mattibmt98/Sata-Multiplier-power-supply/kicad/bom.csv

Reference | Value | Footprint | MPN | DigiKey | DNP
C11,C13,C23,C33,C43,C53 | 1uF | Capacitor_SMD:C_0603_1608Metric | CL10A105KB8NNNC | 1276-1860-1-ND
C12,C22,C32,C42,C52 | 220uF/25V | Capacitor_THT:CP_Radial_D8.0mm_P3.50mm | UVZ1E221MPD | 493-1302-ND
C14,C34,C54 | 10uF/50V | Capacitor_SMD:C_1206_3216Metric | CL31A106KBHNNNE | 1276-2876-1-ND | DNP
C15,C16,C35,C36,C55,C56 | 100nF | Capacitor_SMD:C_0603_1608Metric | CL10B104KB8NNNC | 1276-1000-1-ND | DNP
C17,C18,C37,C38,C57,C58 | 22uF/25V | Capacitor_SMD:C_1206_3216Metric | CL31A226KAHNNNE | 1276-3047-1-ND | DNP
C21 | 2.2uF | Capacitor_SMD:C_0603_1608Metric | CL10A225KO8NNNC | 1276-1040-1-ND
C24,C44,C83,C93 | 10uF/50V | Capacitor_SMD:C_1206_3216Metric | CL31A106KBHNNNE | 1276-2876-1-ND
C25,C26,C45,C46 | 100nF | Capacitor_SMD:C_0603_1608Metric | CL10B104KB8NNNC | 1276-1000-1-ND
C27,C28,C47,C48 | 22uF/25V | Capacitor_SMD:C_1206_3216Metric | CL31A226KAHNNNE | 1276-3047-1-ND
C31 | 4.7uF | Capacitor_SMD:C_0603_1608Metric | CL10A475KO8NNNC | 1276-1784-1-ND
C41 | 10uF | Capacitor_SMD:C_1206_3216Metric | CL31A106KBHNNNE | 1276-2876-1-ND
C51 | 22uF | Capacitor_SMD:C_1206_3216Metric | CL31A226KAHNNNE | 1276-3047-1-ND
C81,C91 | 1000uF/25V | Capacitor_THT:CP_Radial_D10.0mm_P5.00mm | UVR1E102MPD | 493-1065-ND
D11,D21,D31,D41,D51 | 8.2V | Diode_SMD:D_SOD-123 | MMSZ5237B-7-F | MMSZ5237B-FDICT-ND
D12,D22,D32,D42,D52,D81,D91 | GRN | LED_SMD:LED_0603_1608Metric
F1-F5 | 2.6A/5.2A | Fuse:Fuse_1812_4532Metric | 1812L260/16MR | F10827CT-ND
F8,F9 | 8A fast-blow | Fuse:Fuseholder_Clip-5x20mm_Bel_FC-203-22_Lateral_P17.80x5.00mm_D1.17mm_Horizontal | FC-203-22 | 507-1703-ND
J1-J5 | 12V/GND/GND/5V | Connector_PinHeader_2.54mm:PinHeader_1x04_P2.54mm_Vertical | PRPC004SAAN-RC | S1011EC-04-ND
J8,J9 | 12V DC 5-8A | Connector_BarrelJack:BarrelJack_CUI_PJ-063AH_Horizontal | PJ-063AH | CP-063AH-ND
L1,L3,L5 | 4.7uH/4.5A | Inductor_SMD:L_Bourns_SRN6045TA | SRN6045TA-4R7M | SRN6045TA-4R7MTR-ND | DNP
L2,L4 | 4.7uH/4.5A | Inductor_SMD:L_Bourns_SRN6045TA | SRN6045TA-4R7M | SRN6045TA-4R7MTR-ND
Q1-Q5 | AO3401A | Package_TO_SOT_SMD:SOT-23 | AO3401A | 785-1001-1-ND
Q8,Q9 | AOD4185 | Package_TO_SOT_SMD:TO-252-3_TabPin2 | AOD4185 | 785-1222-2-ND
R11,R21,R31,R41,R51 | 220k | Resistor_SMD:R_0603_1608Metric | RC0603FR-07220KL | 311-220KHRCT-ND
R12,R32,R52 | 56k | Resistor_SMD:R_0603_1608Metric | RC0603FR-0756KL | 311-56KHRCT-ND | DNP
R13,R33,R53 | 10k | Resistor_SMD:R_0603_1608Metric | RC0603FR-0710KL | 311-10.0KHRCT-ND | DNP
R14,R34,R54 | 100k | Resistor_SMD:R_0603_1608Metric | RC0603FR-07100KL | 311-100KHRCT-ND | DNP
R15,R25,R35,R45,R55 | 1.5k | Resistor_SMD:R_0603_1608Metric
R22,R42 | 56k | Resistor_SMD:R_0603_1608Metric | RC0603FR-0756KL | 311-56KHRCT-ND
R23,R43 | 10k | Resistor_SMD:R_0603_1608Metric | RC0603FR-0710KL | 311-10.0KHRCT-ND
R24,R44 | 100k | Resistor_SMD:R_0603_1608Metric | RC0603FR-07100KL | 311-100KHRCT-ND
R61,R62,R64 | 0R | Resistor_SMD:R_1206_3216Metric
R63 | 0R | Resistor_SMD:R_1206_3216Metric |  |  | DNP
R81,R91 | 4.7k | Resistor_SMD:R_0603_1608Metric
U1,U3,U5 | TPS563200 | Package_TO_SOT_SMD:SOT-23-6 | TPS563200DDCR | 296-43663-1-ND | DNP
U2,U4 | TPS563200 | Package_TO_SOT_SMD:SOT-23-6 | TPS563200DDCR | 296-43663-1-ND
