mattibmt98/Sata-Multiplier-power-supply/kicad/digikey_bom.csv

Order Qty | DigiKey PN | MPN | Manufacturer | Description | References | Board Qty | Fitted in default build | Note
10 | 445-7468-1-ND | C1608X5R1H105K080AB | TDK | 1uF 50V X5R 0603 | C11,C13,C23,C33,C43,C53 | 6 | 6 | SUBSTITUTE for Samsung CL10A105KB8NNNC (out of stock)
10 | 445-7478-1-ND | C1608X5R1C475K080AC | TDK | 4.7uF 16V X5R 0603 | C31 | 1 | 1 | SUBSTITUTE for Samsung CL10A475KO8NNNC (out of stock)
10 | 1276-1040-1-ND | CL10A225KO8NNNC | Samsung | 2.2uF 16V X5R 0603 | C21 | 1 | 1 | as designed
12 | 311-1344-1-ND | CC0603KRX7R9BB104 | YAGEO | 100nF 50V X7R 0603 | C15,C16,C25,C26,C35,C36,C45,C46,C55,C56 | 10 | 4 | SUBSTITUTE for Samsung CL10B104KB8NNNC (out of stock)
10 | 13-CC1206KKX5R9BB106CT-ND | CC1206KKX5R9BB106 | YAGEO | 10uF 50V X5R 1206 | C14,C24,C34,C44,C54,C83,C93,C41 | 8 | 5 | SUBSTITUTE for Samsung CL31A106KBHNNNE (out of stock until Jul 2027)
13 | 445-6000-1-ND | C3216X5R1E226M160AB | TDK | 22uF 25V X5R 1206 | C17,C18,C27,C28,C37,C38,C47,C48,C57,C58,C51 | 11 | 5 | SUBSTITUTE for Samsung CL31A226KAHNNNE (out of stock until Jul 2027)
5 | 493-1302-ND | UVZ1E221MPD | Nichicon | 220uF 25V radial 8x11.5 P3.5 | C12,C22,C32,C42,C52 | 5 | 5 | as designed
2 | P14424-ND | EEU-FR1E102 | Panasonic | 1000uF 25V radial 10mm P5.0 (22mm tall) | C81,C91 | 2 | 2 | SUBSTITUTE for Nichicon UVR1E102MPD (out of stock until Jan 2027); 2mm taller
7 | MMSZ5237B-FDICT-ND | MMSZ5237B-7-F | Diodes Inc | 8.2V 500mW zener SOD-123 | D11,D21,D31,D41,D51 | 5 | 5 | as designed
10 | 160-1446-1-ND | LTST-C191KGKT | Lite-On | Green LED 0603 | D12,D22,D32,D42,D52,D81,D91 | 7 | 7 | NEW - schematic had no part number
5 | MINISMDC260F/16-2CT-ND | MINISMDC260F/16-2 | Littelfuse | PTC 2.6A hold 5A trip 16V 1812 | F1,F2,F3,F4,F5 | 5 | 5 | SUBSTITUTE for Littelfuse 1812L260/16MR (out of stock until Dec 2026); same ratings
4 | 5923-FC-203BRIGHTTIN-ND | FC-203 BRIGHT TIN | Bel Fuse | 5x20mm fuse clip (one clip) | F8,F9 | 4 | 4 | PN 507-1703-ND was renumbered; each footprint holds 2 clips, two inputs = 4
3 | F2396-ND | 0217008.HXP | Littelfuse | Fuse 8A fast 250V 5x20mm glass | F8,F9 (cartridge) | 2 | 2 | was 10A 0217010.HXP (F2398-ND): each input now carries <=4.4A and the jack contact is 8A, so 8A; one per input + 1 spare. DigiKey PN taken from a web search of the listing - confirm on the cart
5 | 35-PRPC004SAAN-RC-ND | PRPC004SAAN-RC | Sullins | Header 1x04 2.54mm | J1,J2,J3,J4,J5 | 5 | 5 | PN S1011EC-04-ND was renumbered
2 | CP-063AH-ND | PJ-063AH | Same Sky (CUI) | DC barrel jack 2.0mm 8A | J8,J9 | 2 | 2 | as designed; second jack feeds bays 4-5
5 | 283-SDCHA1V6045-4R7-RCT-ND | SDCHA1V6045-4R7-R | Eaton | 4.7uH 4.5A Isat 6.8A 26mOhm 6x6mm | L1,L2,L3,L4,L5 | 5 | 2 | SUBSTITUTE for Bourns SRN6045TA-4R7M (out of stock until Jan 2027) - LAND PATTERN NOT VERIFIED
5 | 785-1001-1-ND | AO3401A | Alpha & Omega | P-MOSFET 30V 4A SOT-23 | Q1,Q2,Q3,Q4,Q5 | 5 | 5 | as designed
2 | 785-1222-1-ND | AOD4185 | Alpha & Omega | P-MOSFET 40V 40A TO-252 | Q8,Q9 | 2 | 2 | schematic had 785-1222-2-ND (reel of 2500); cut tape instead
10 | 311-220KHRCT-ND | RC0603FR-07220KL | YAGEO | 220k 1% 0603 | R11,R21,R31,R41,R51 | 5 | 5 | as designed
10 | 311-56KHRCT-ND | RC0603FR-0756KL | YAGEO | 56k 1% 0603 | R12,R22,R32,R42,R52 | 5 | 2 | as designed
10 | RMCF0603FT10K0CT-ND | RMCF0603FT10K0 | Stackpole | 10k 1% 0603 | R13,R23,R33,R43,R53 | 5 | 2 | SUBSTITUTE for YAGEO RC0603FR-0710KL (out of stock)
10 | RMCF0603FT100KCT-ND | RMCF0603FT100K | Stackpole | 100k 1% 0603 | R14,R24,R34,R44,R54 | 5 | 2 | SUBSTITUTE for YAGEO RC0603FR-07100KL (out of stock)
10 | 311-1.50KHRCT-ND | RC0603FR-071K5L | YAGEO | 1.5k 1% 0603 | R15,R25,R35,R45,R55 | 5 | 5 | NEW - schematic had no part number
10 | 311-4.70KHRCT-ND | RC0603FR-074K7L | YAGEO | 4.7k 1% 0603 | R81,R91 | 2 | 2 | NEW - schematic had no part number
10 | 311-0.0ERCT-ND | RC1206JR-070RL | YAGEO | 0R jumper 1206 | R61,R62,R63,R64 | 4 | 3 | NEW - schematic had no part number
5 | 296-43663-1-ND | TPS563200DDCR | Texas Instruments | Buck 4.5-17V 3A SOT-23-6 | U1,U2,U3,U4,U5 | 5 | 2 | as designed
