mattibmt98/Sata-Multiplier-power-supply/kicad/sata_psu.pdf

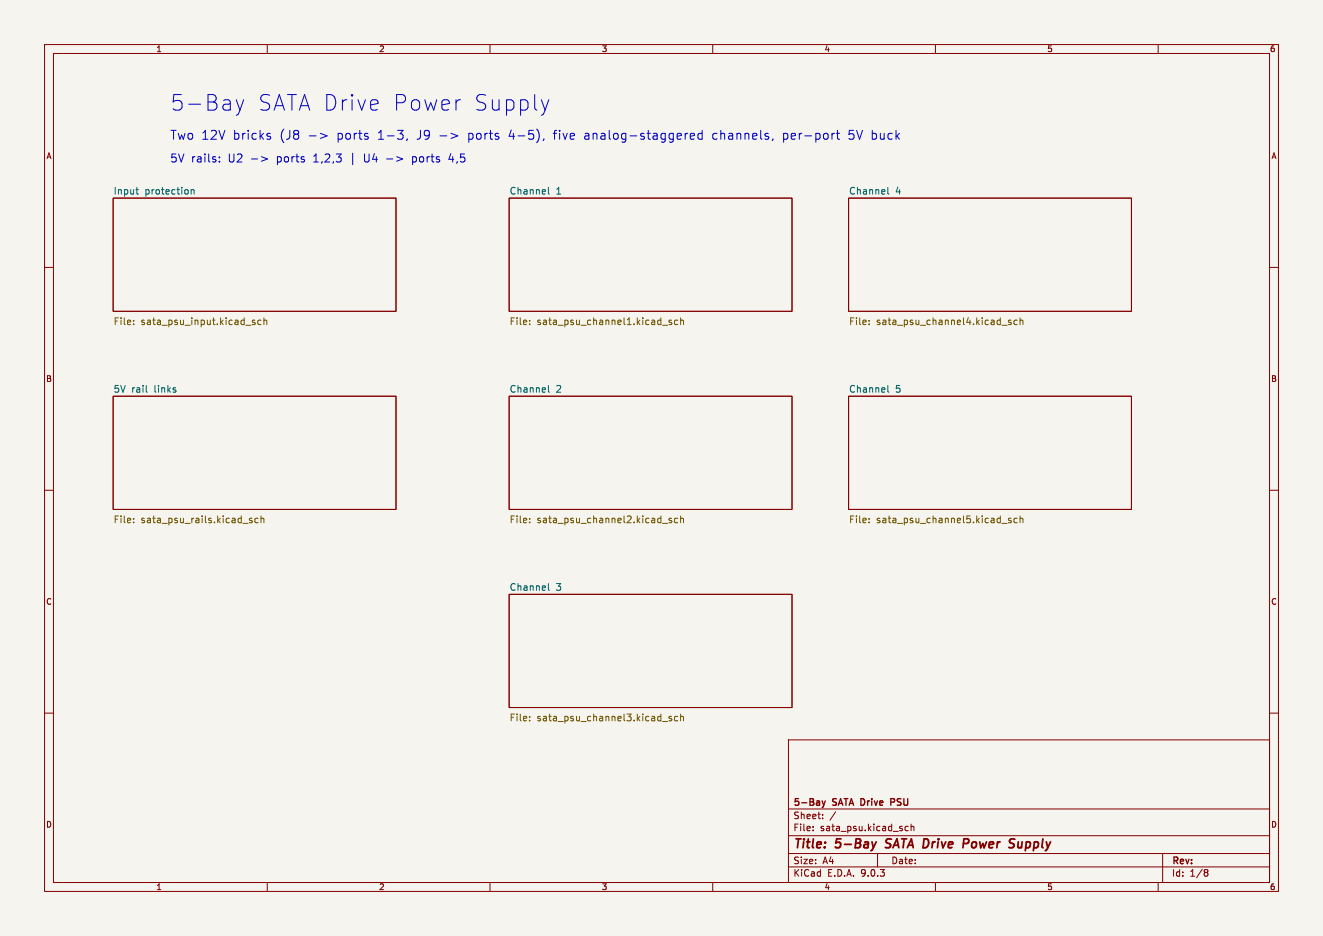
[picture p1: page 1]

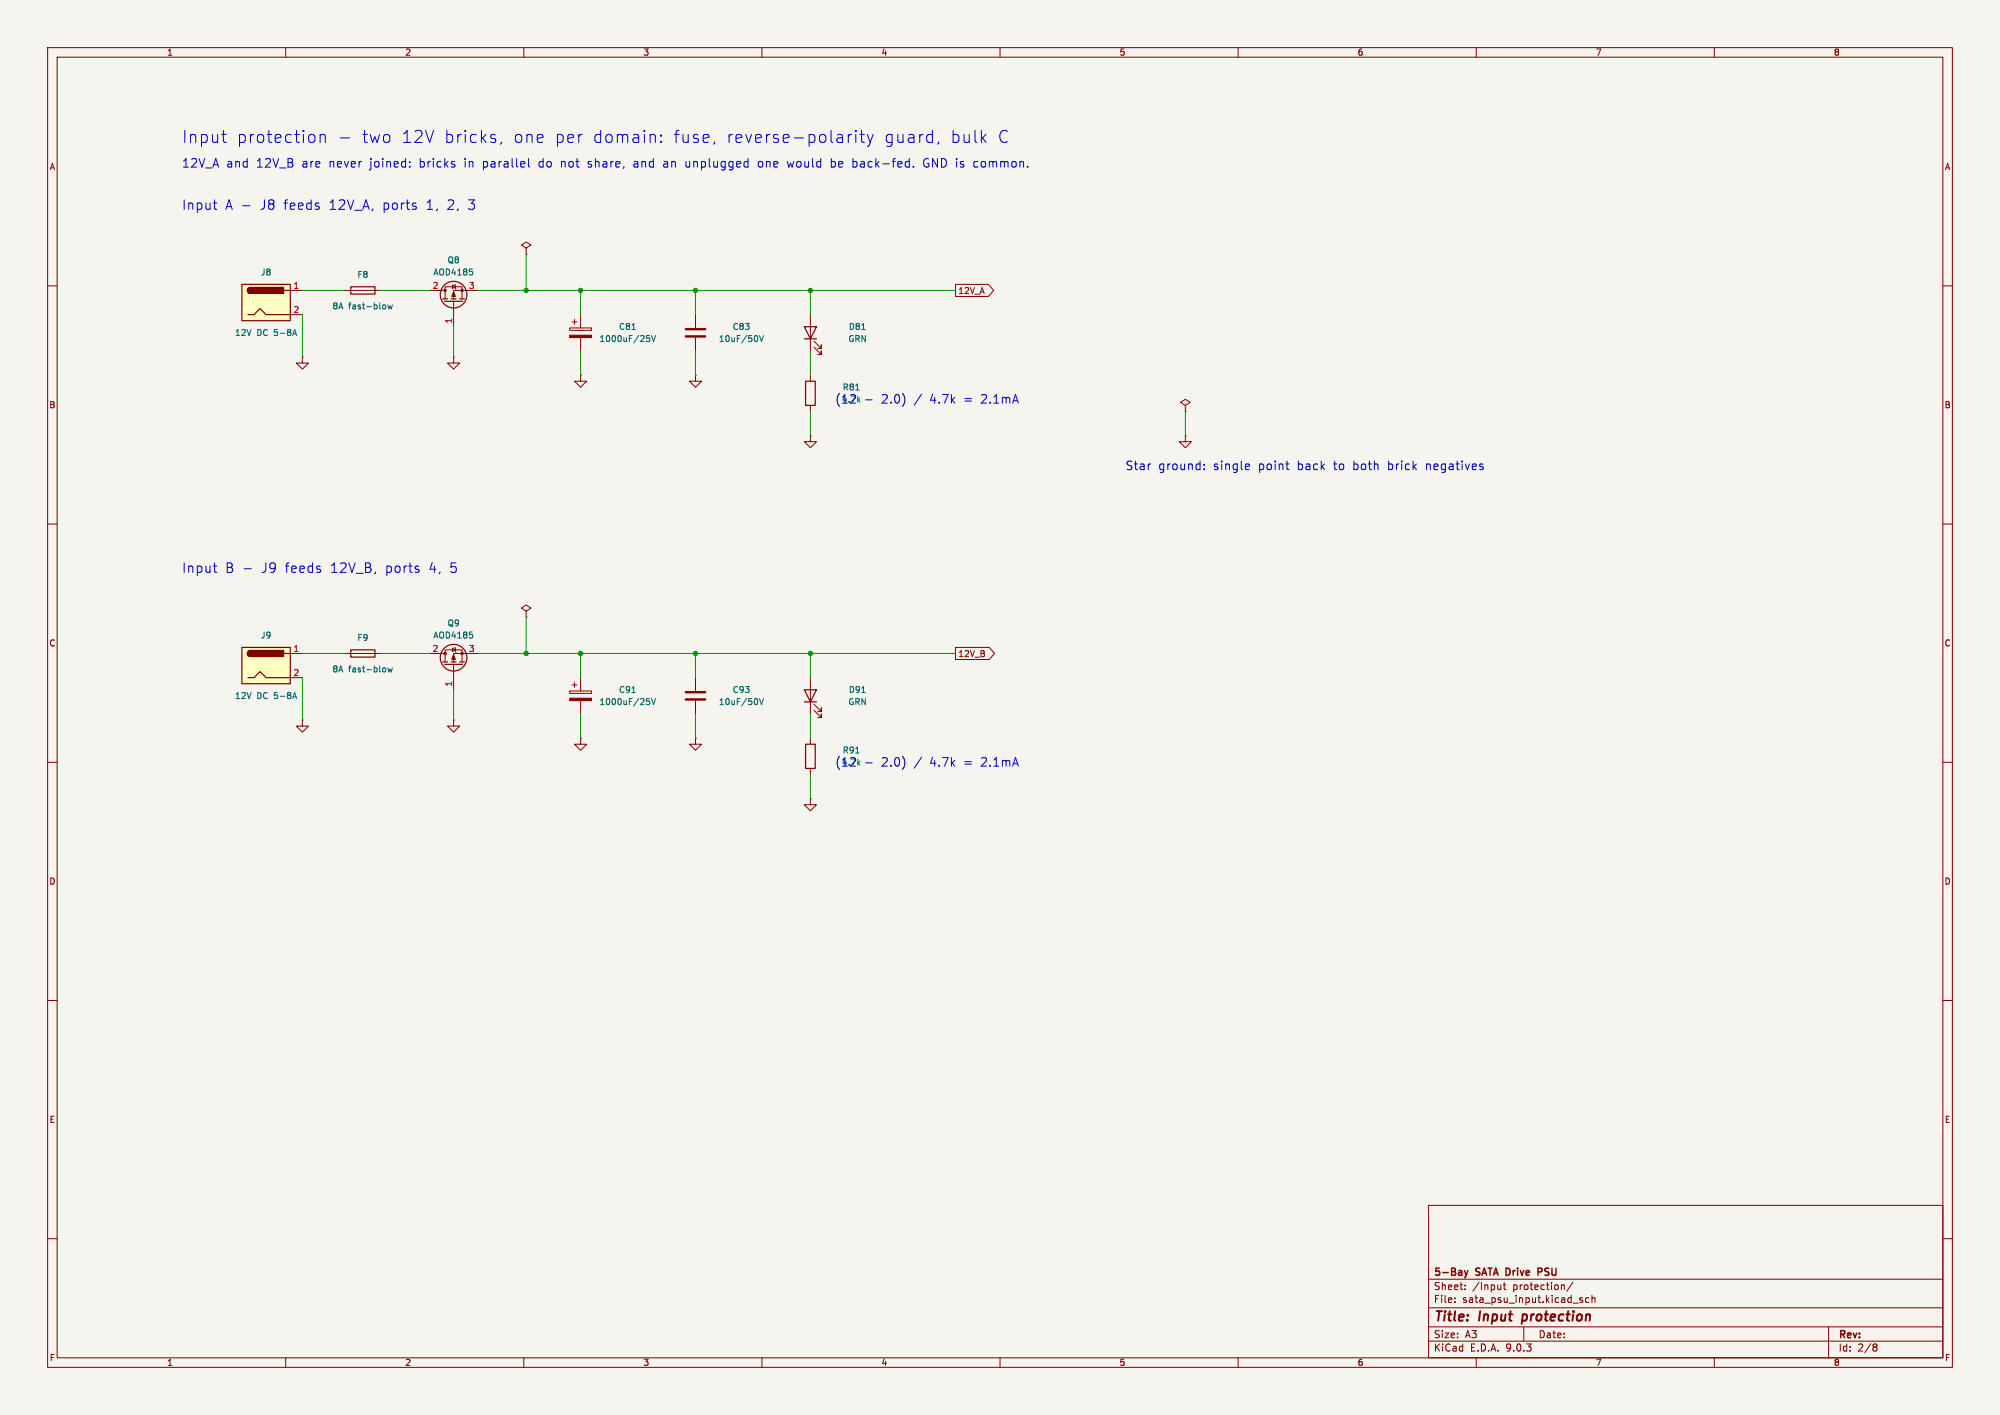
[picture p2: page 2]

Id: 2/8 Title: Input protection

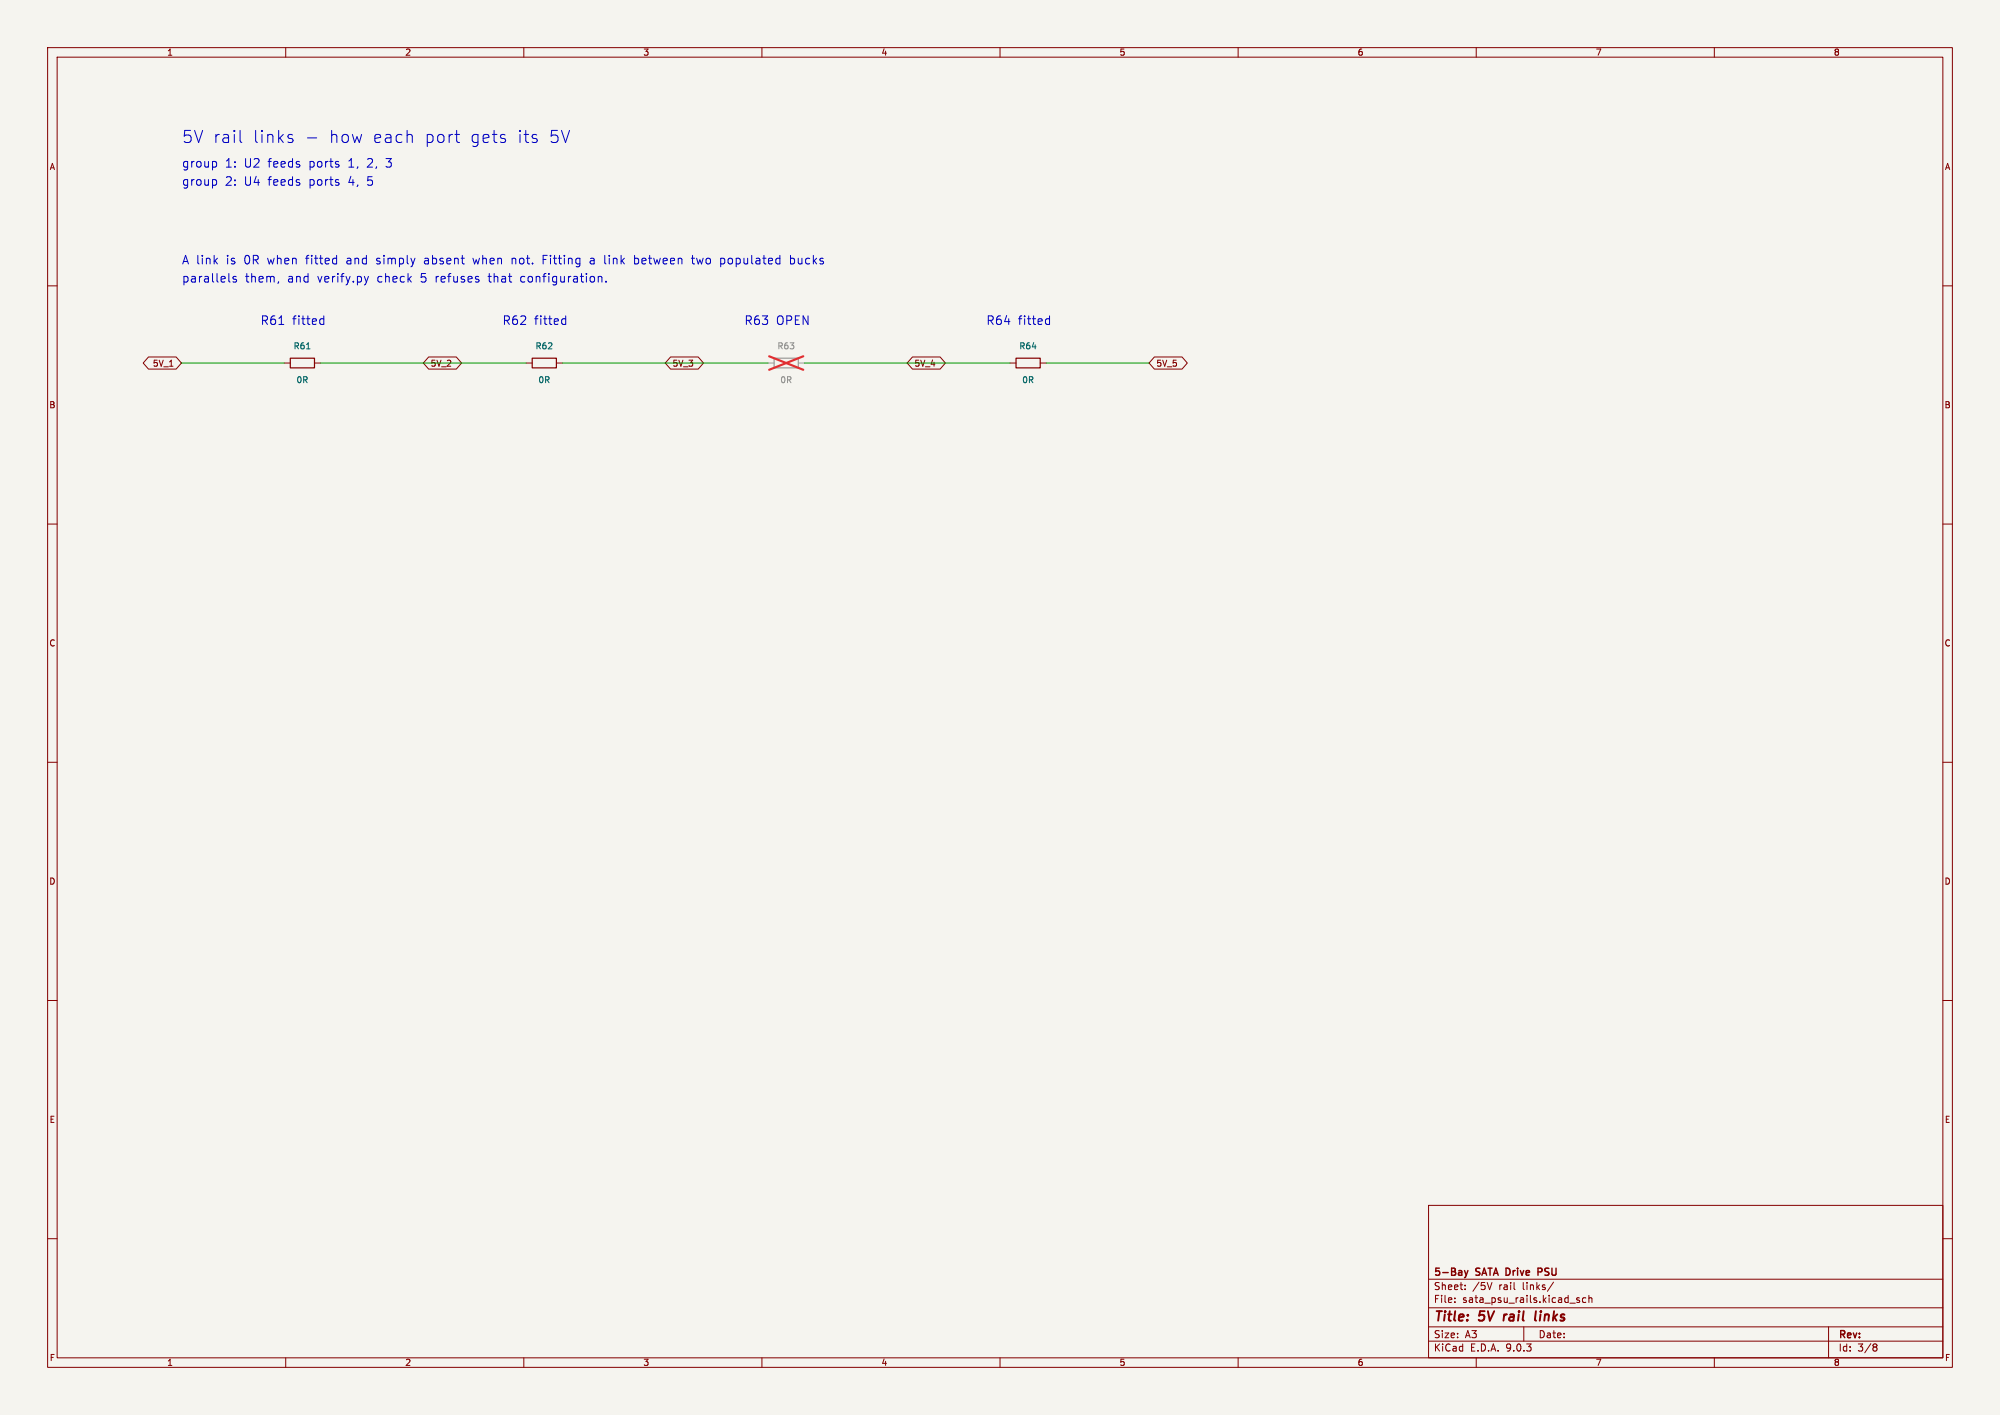
[picture p3: page 3]

Id: 3/8 Title: 5V rail links

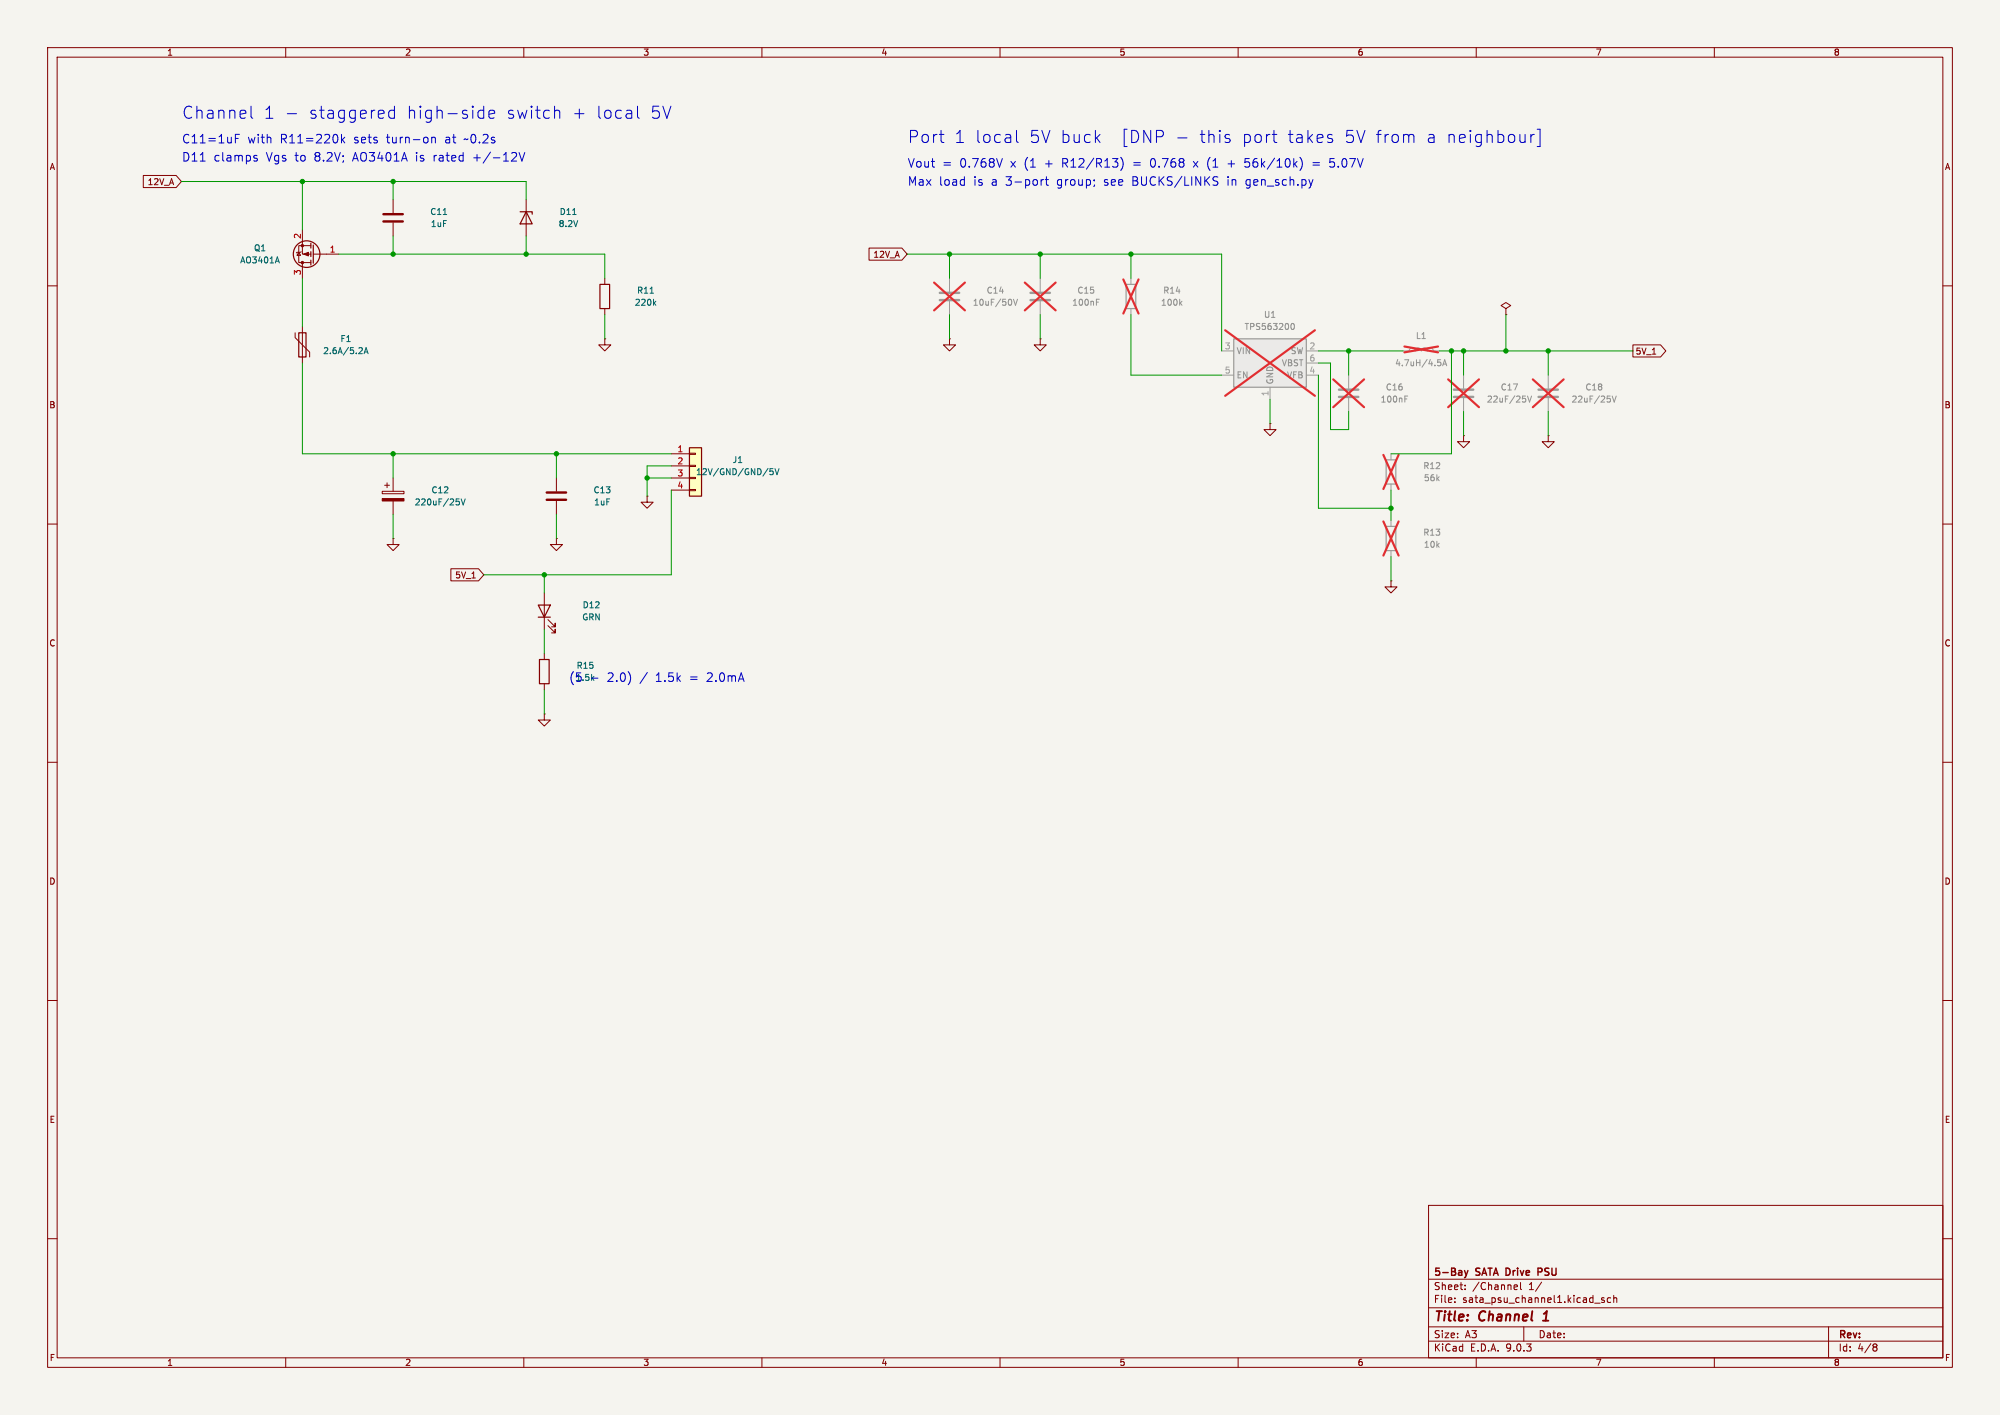
[picture p4: page 4]

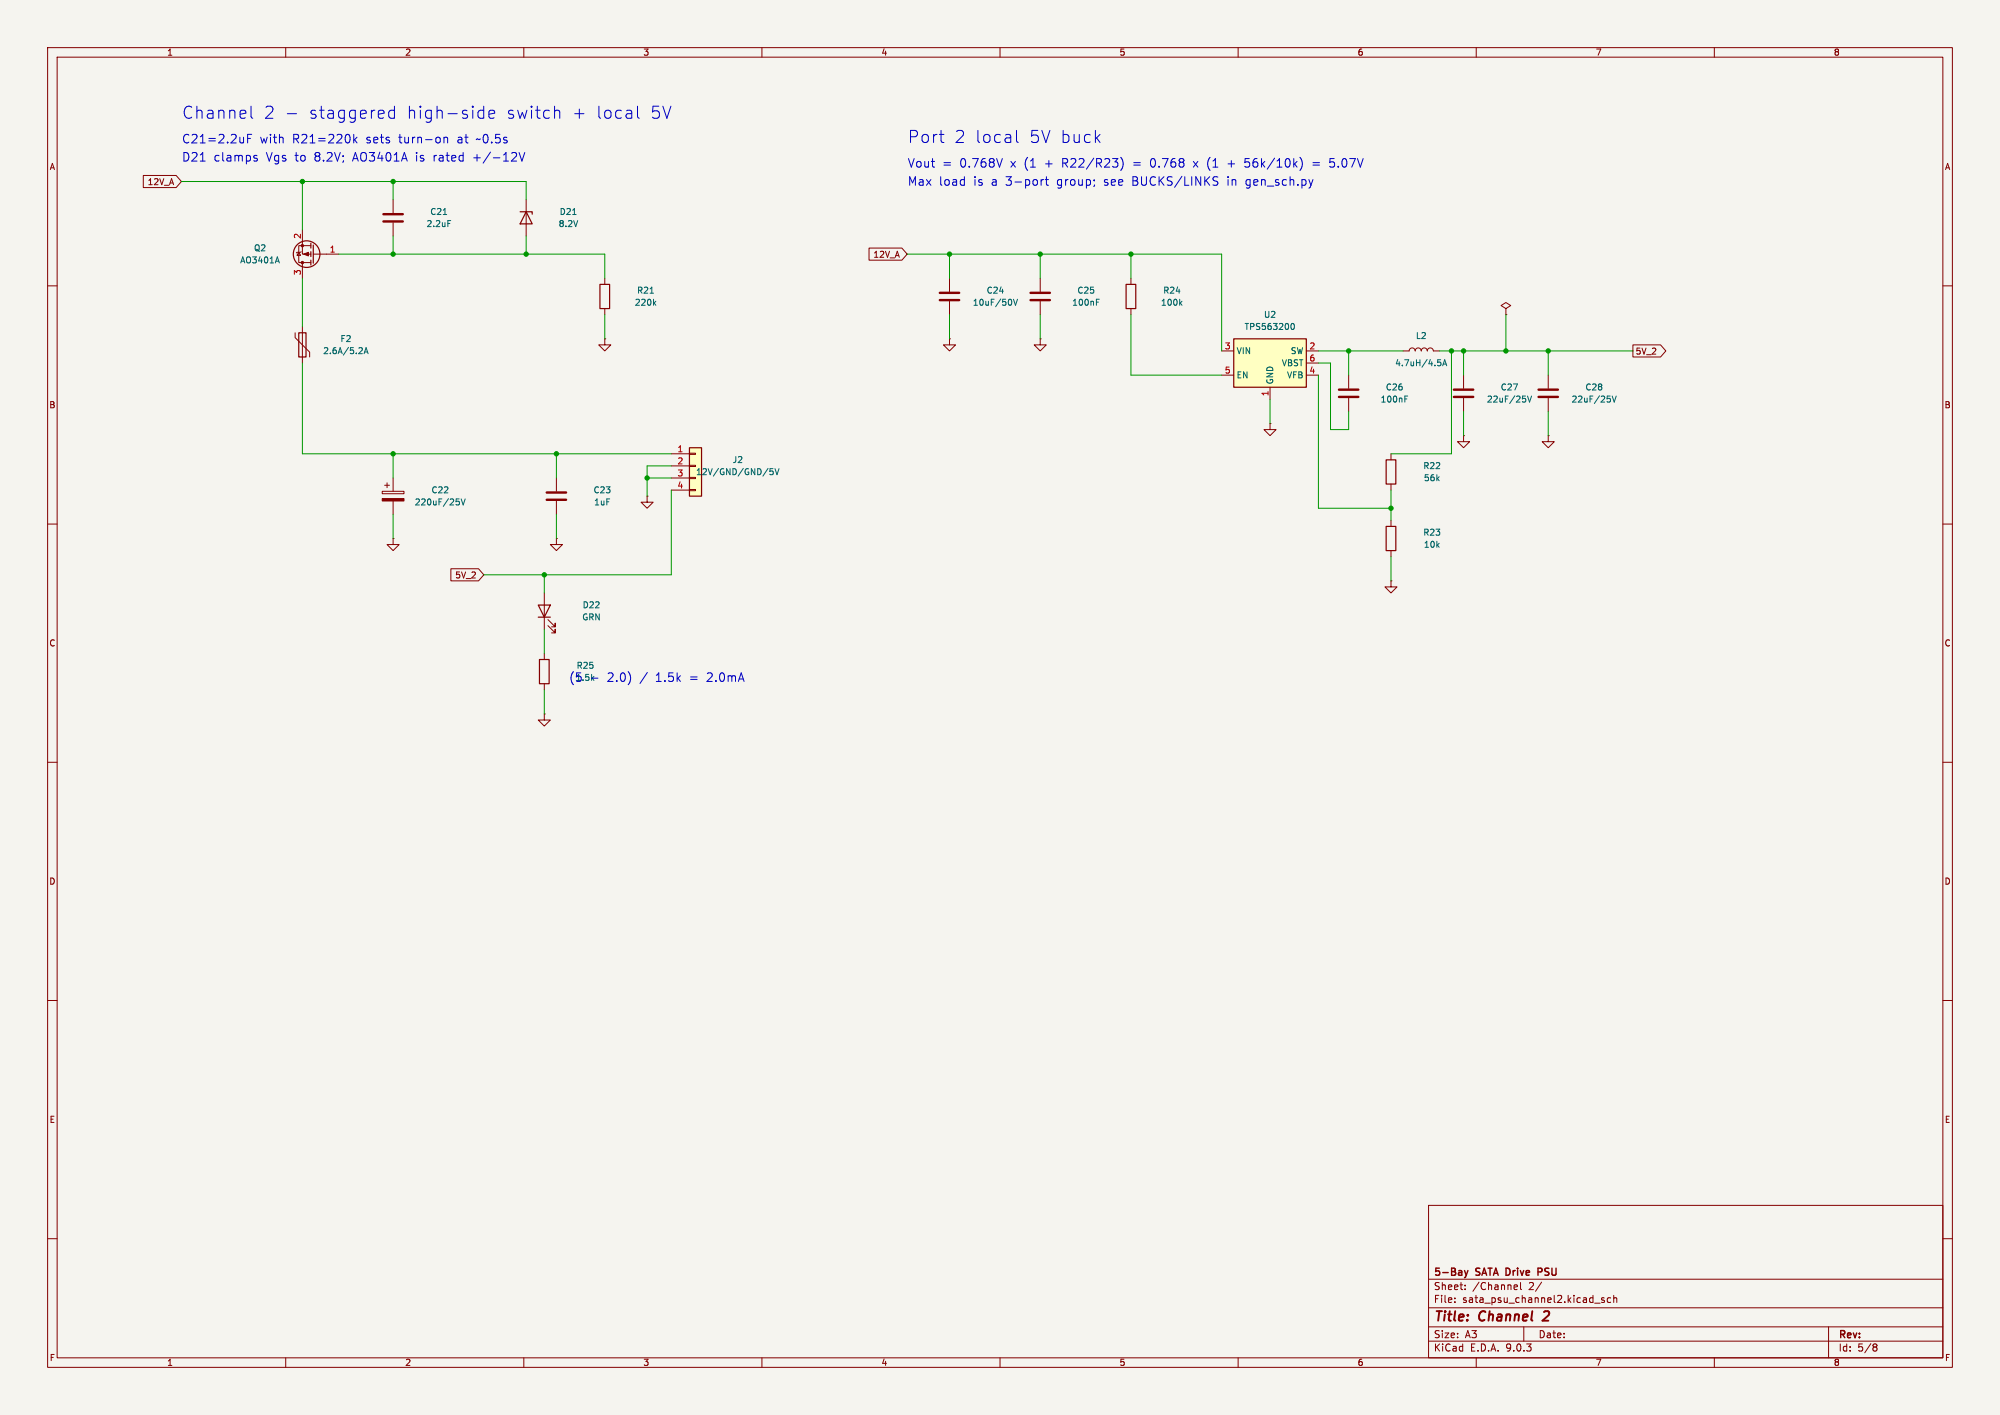
[picture p5: page 5]

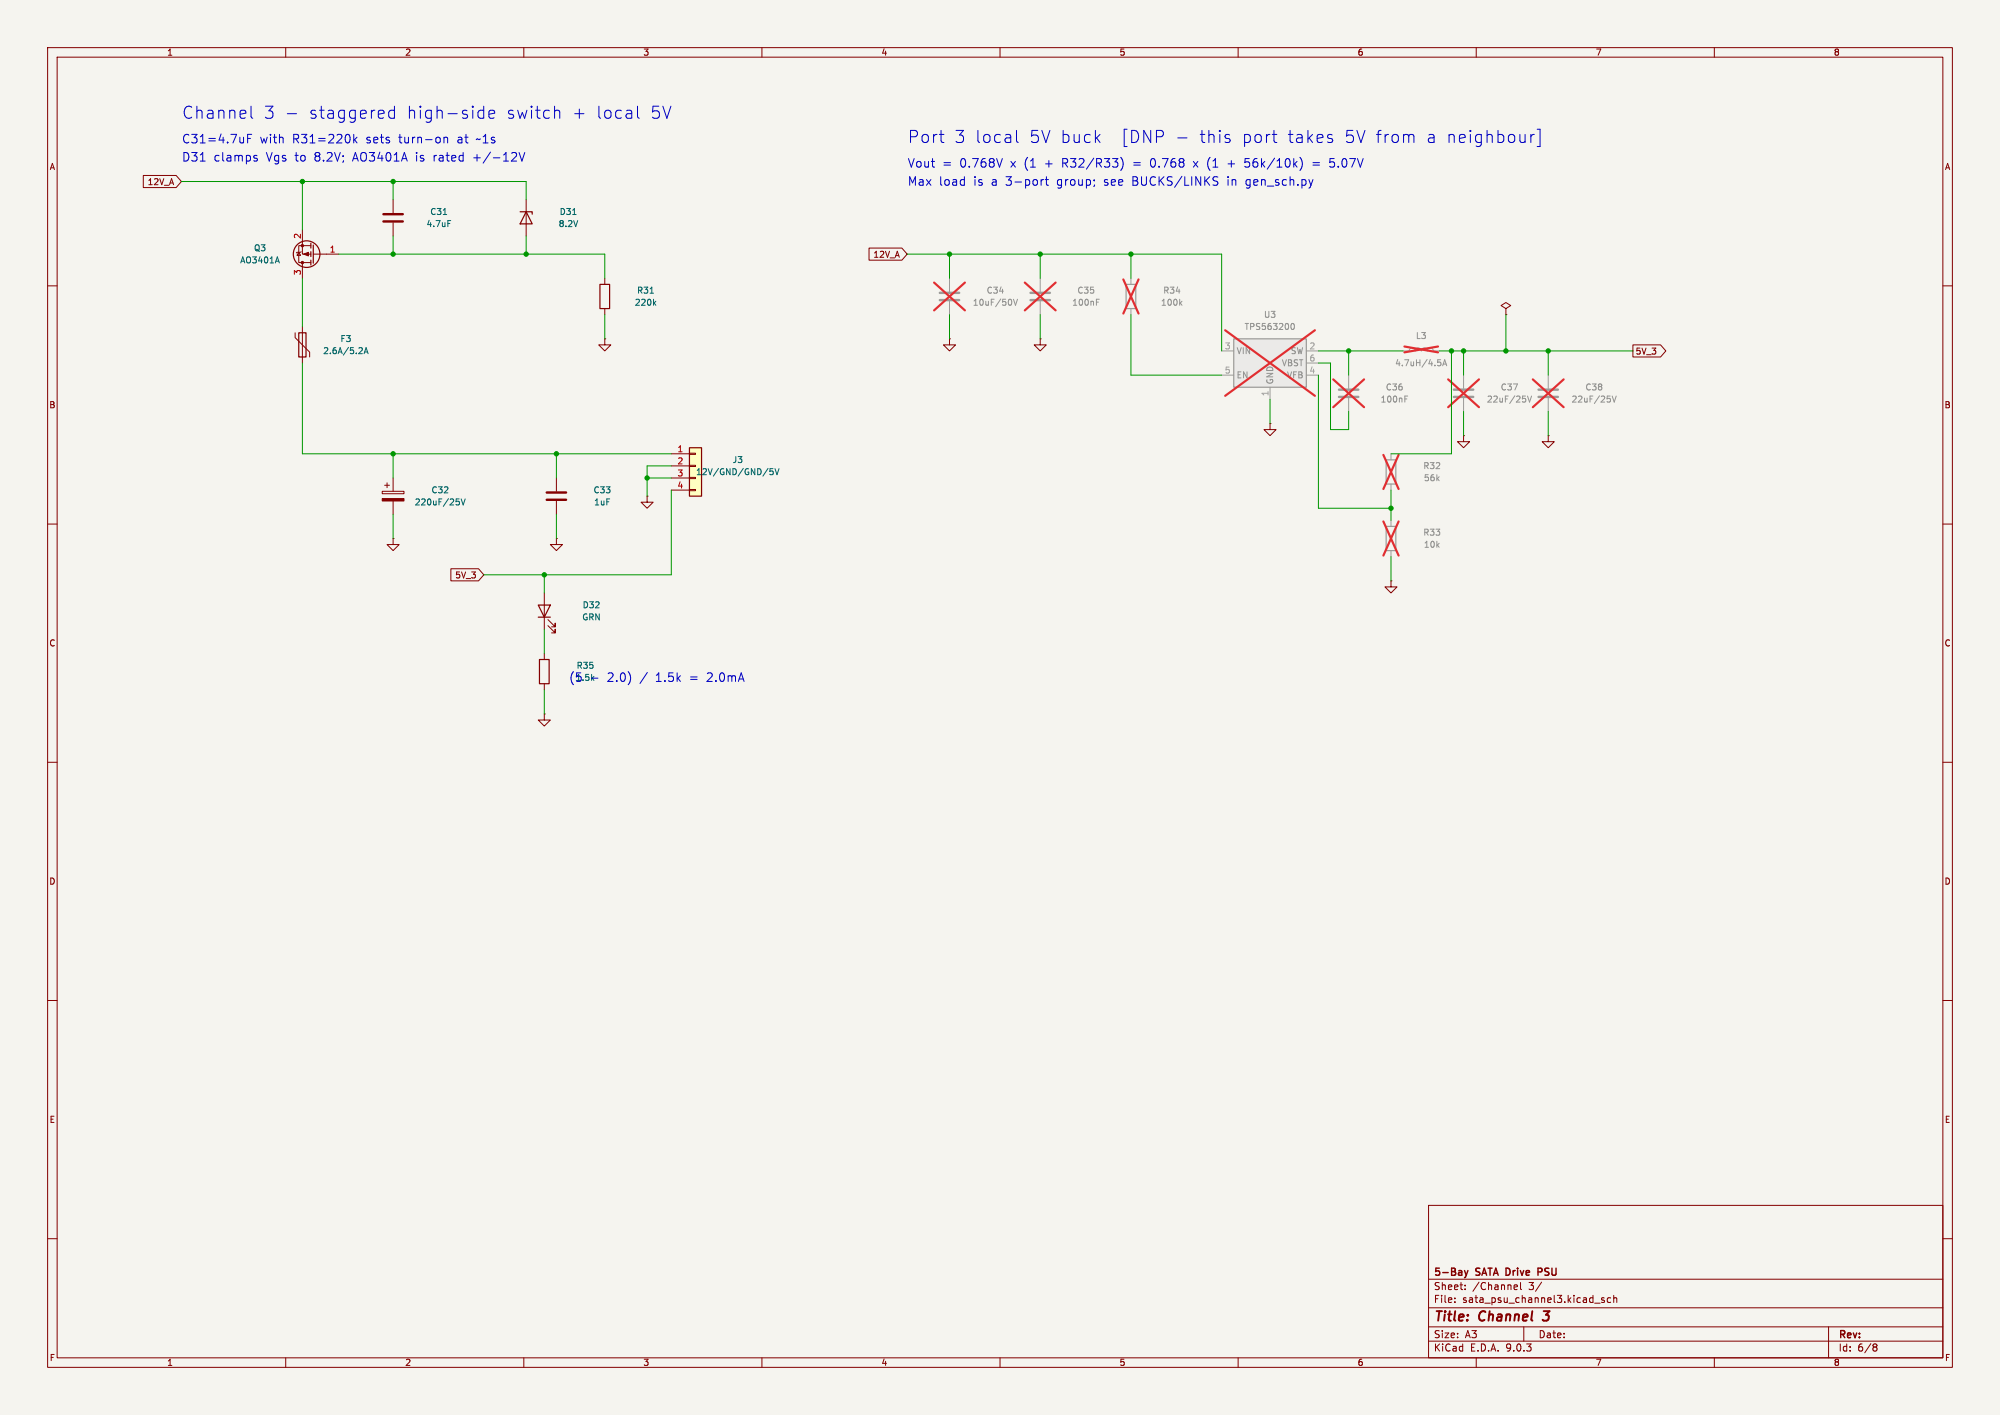
[picture p6: page 6]

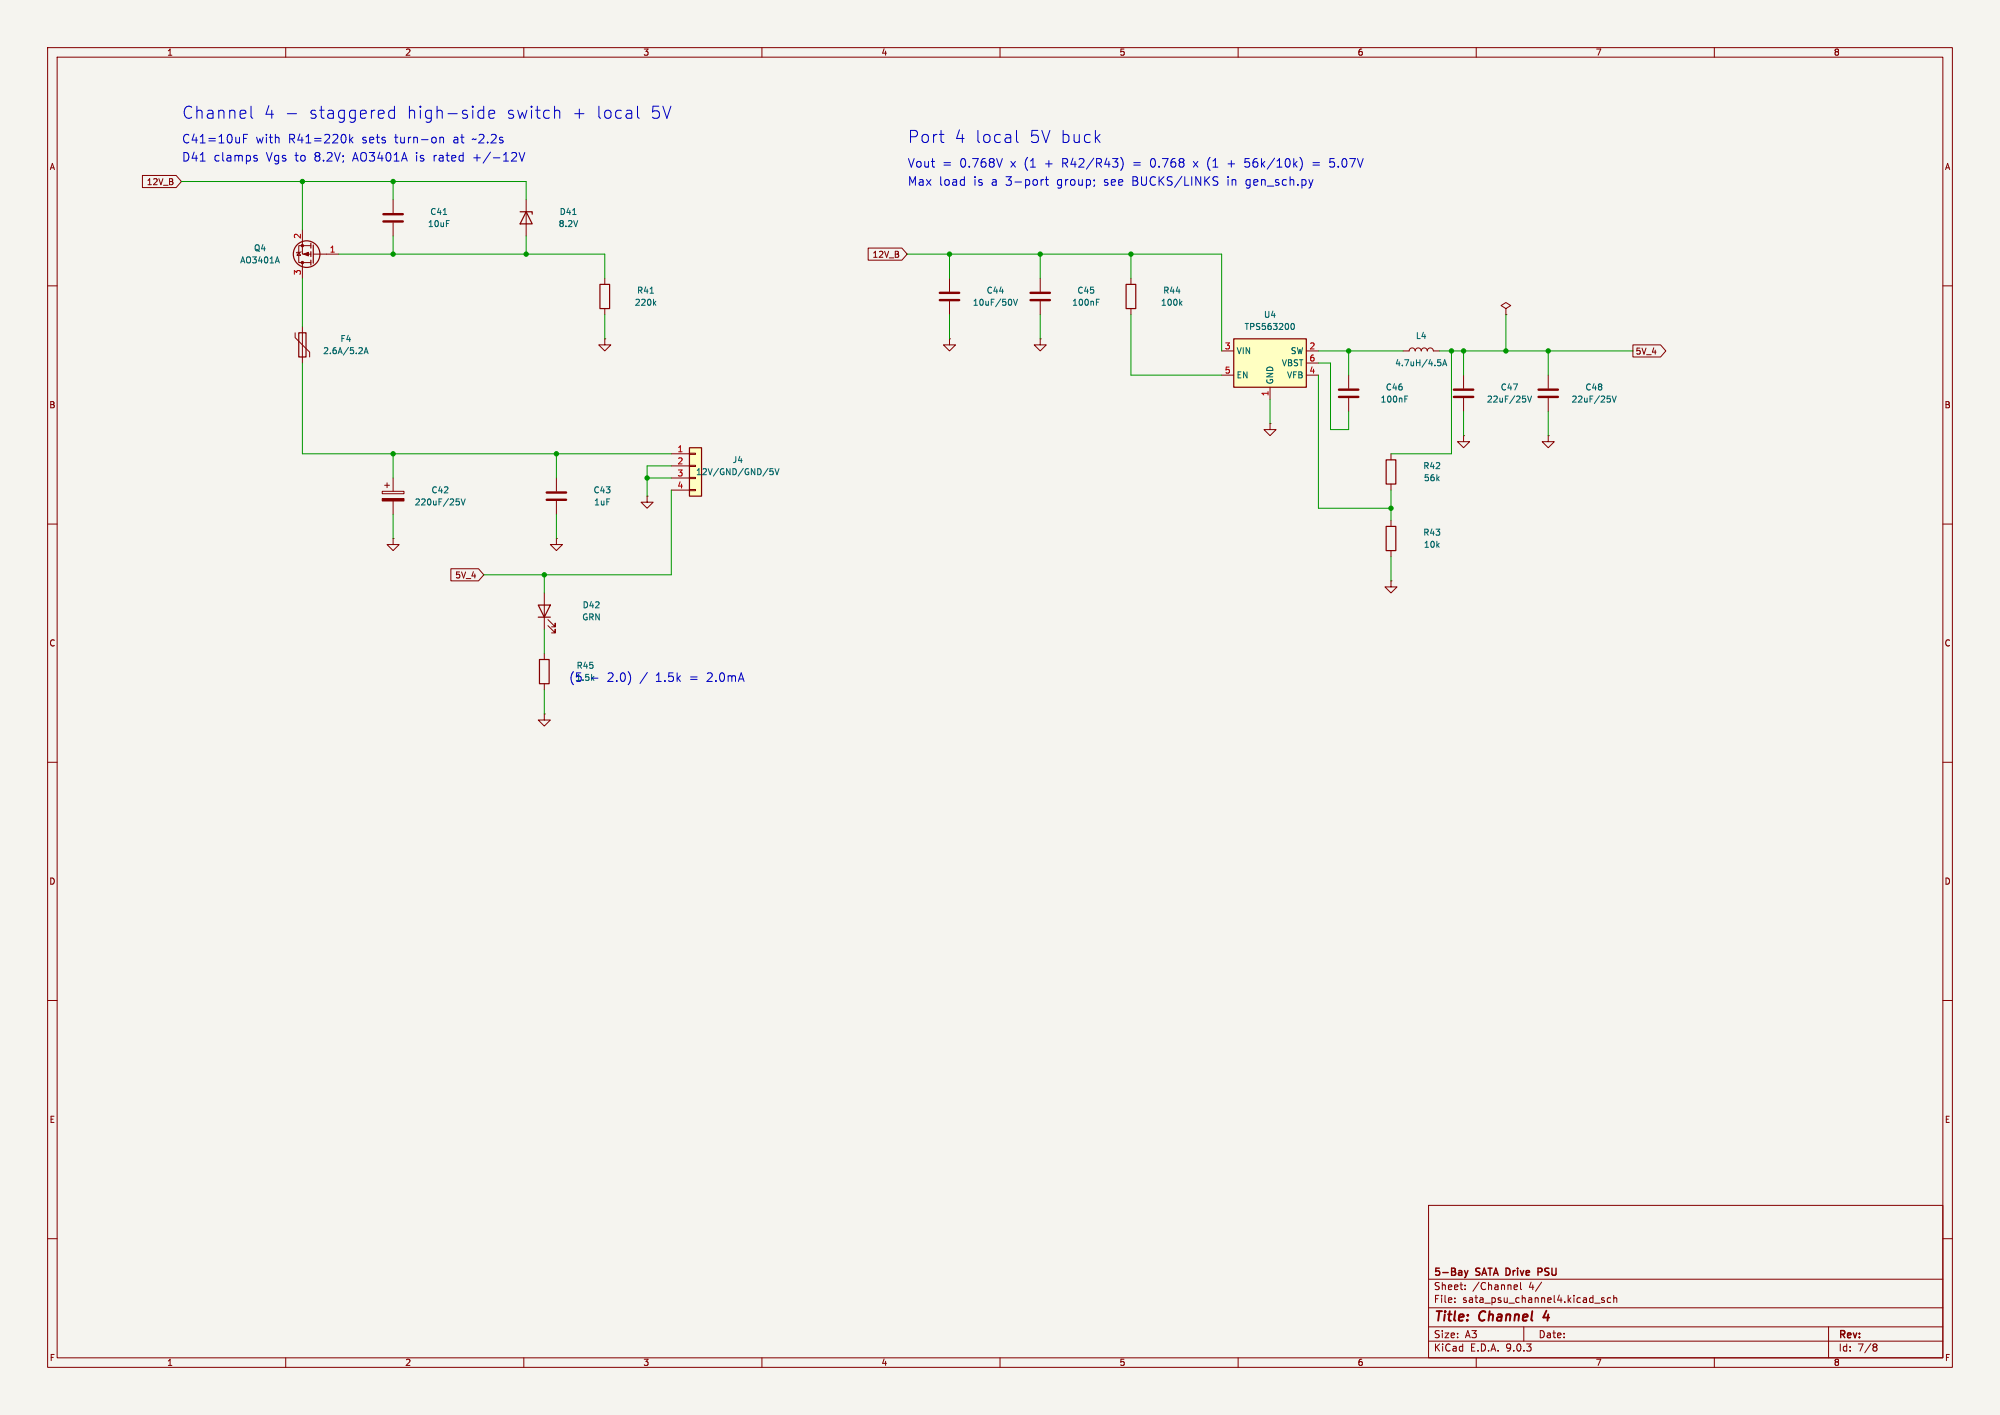
[picture p7: page 7]

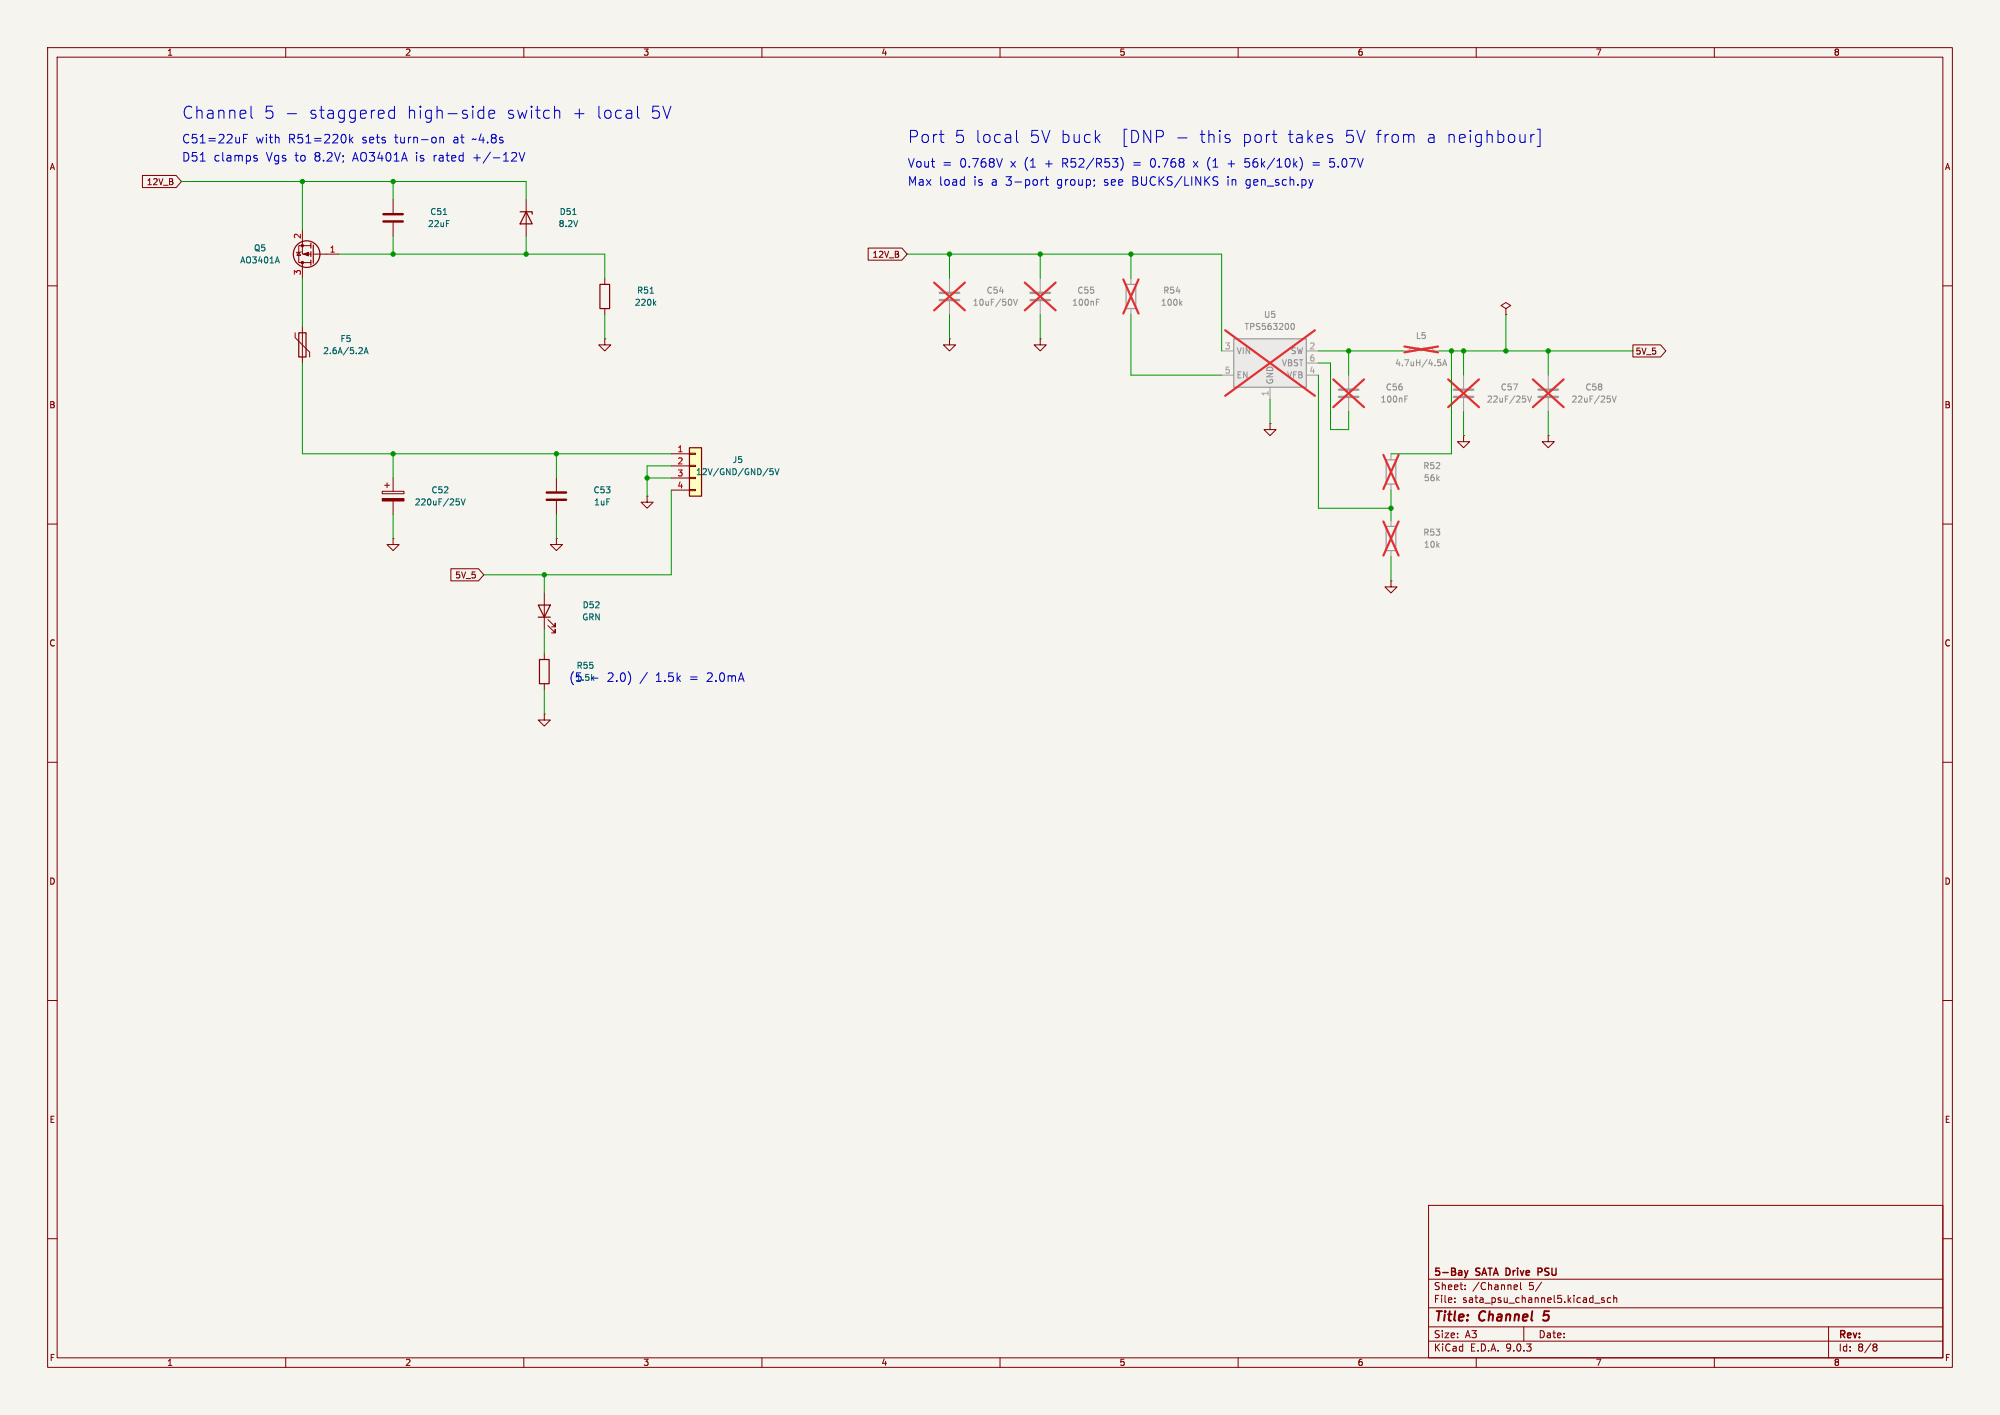
[picture p8: page 8]
