mattibmt98/Sata-Multiplier-power-supply/kicad/sata_psu.kicad_pcb

## KiCad design kicad/sata_psu.kicad_pcb (2026-11-10)

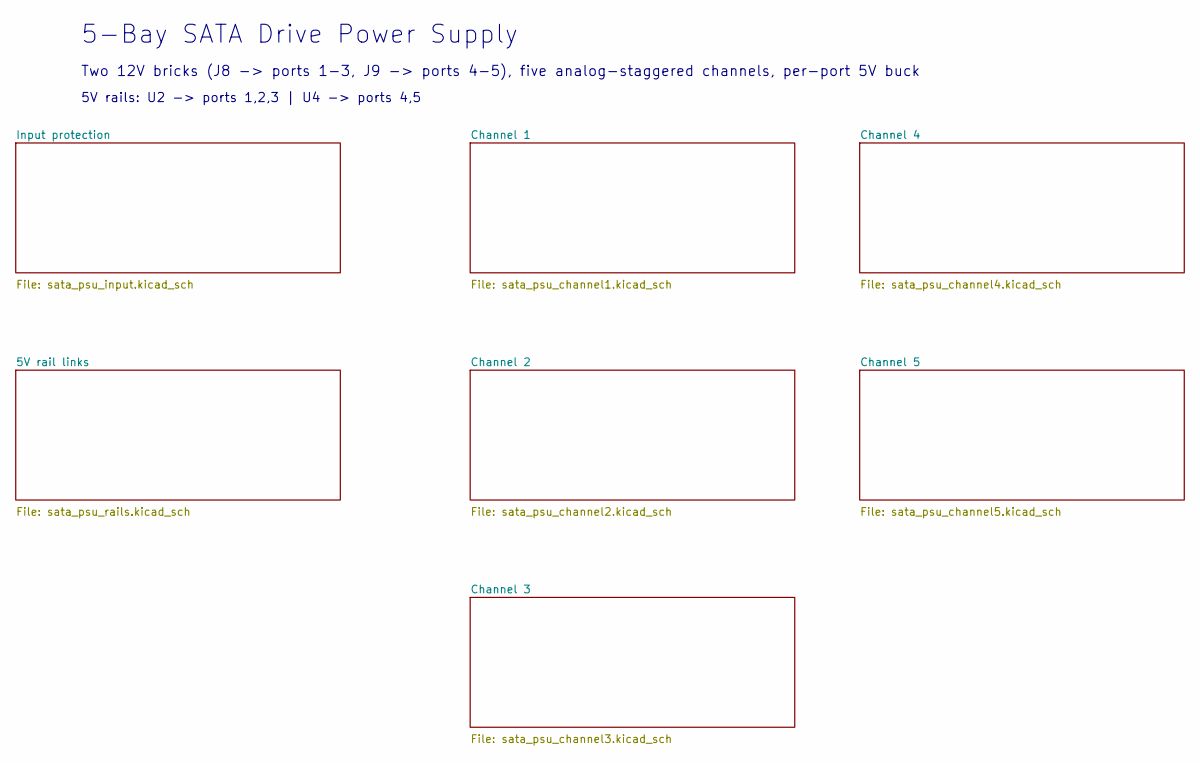
[picture p9: schematic sata_psu.kicad_sch, 5-Bay SATA Drive Power Supply]

Notes on the sheet:
5-Bay SATA Drive Power Supply
Two 12V bricks (J8 -> ports 1-3, J9 -> ports 4-5), five analog-staggered channels, per-port 5V buck
5V rails: U2 -> ports 1,2,3 | U4 -> ports 4,5

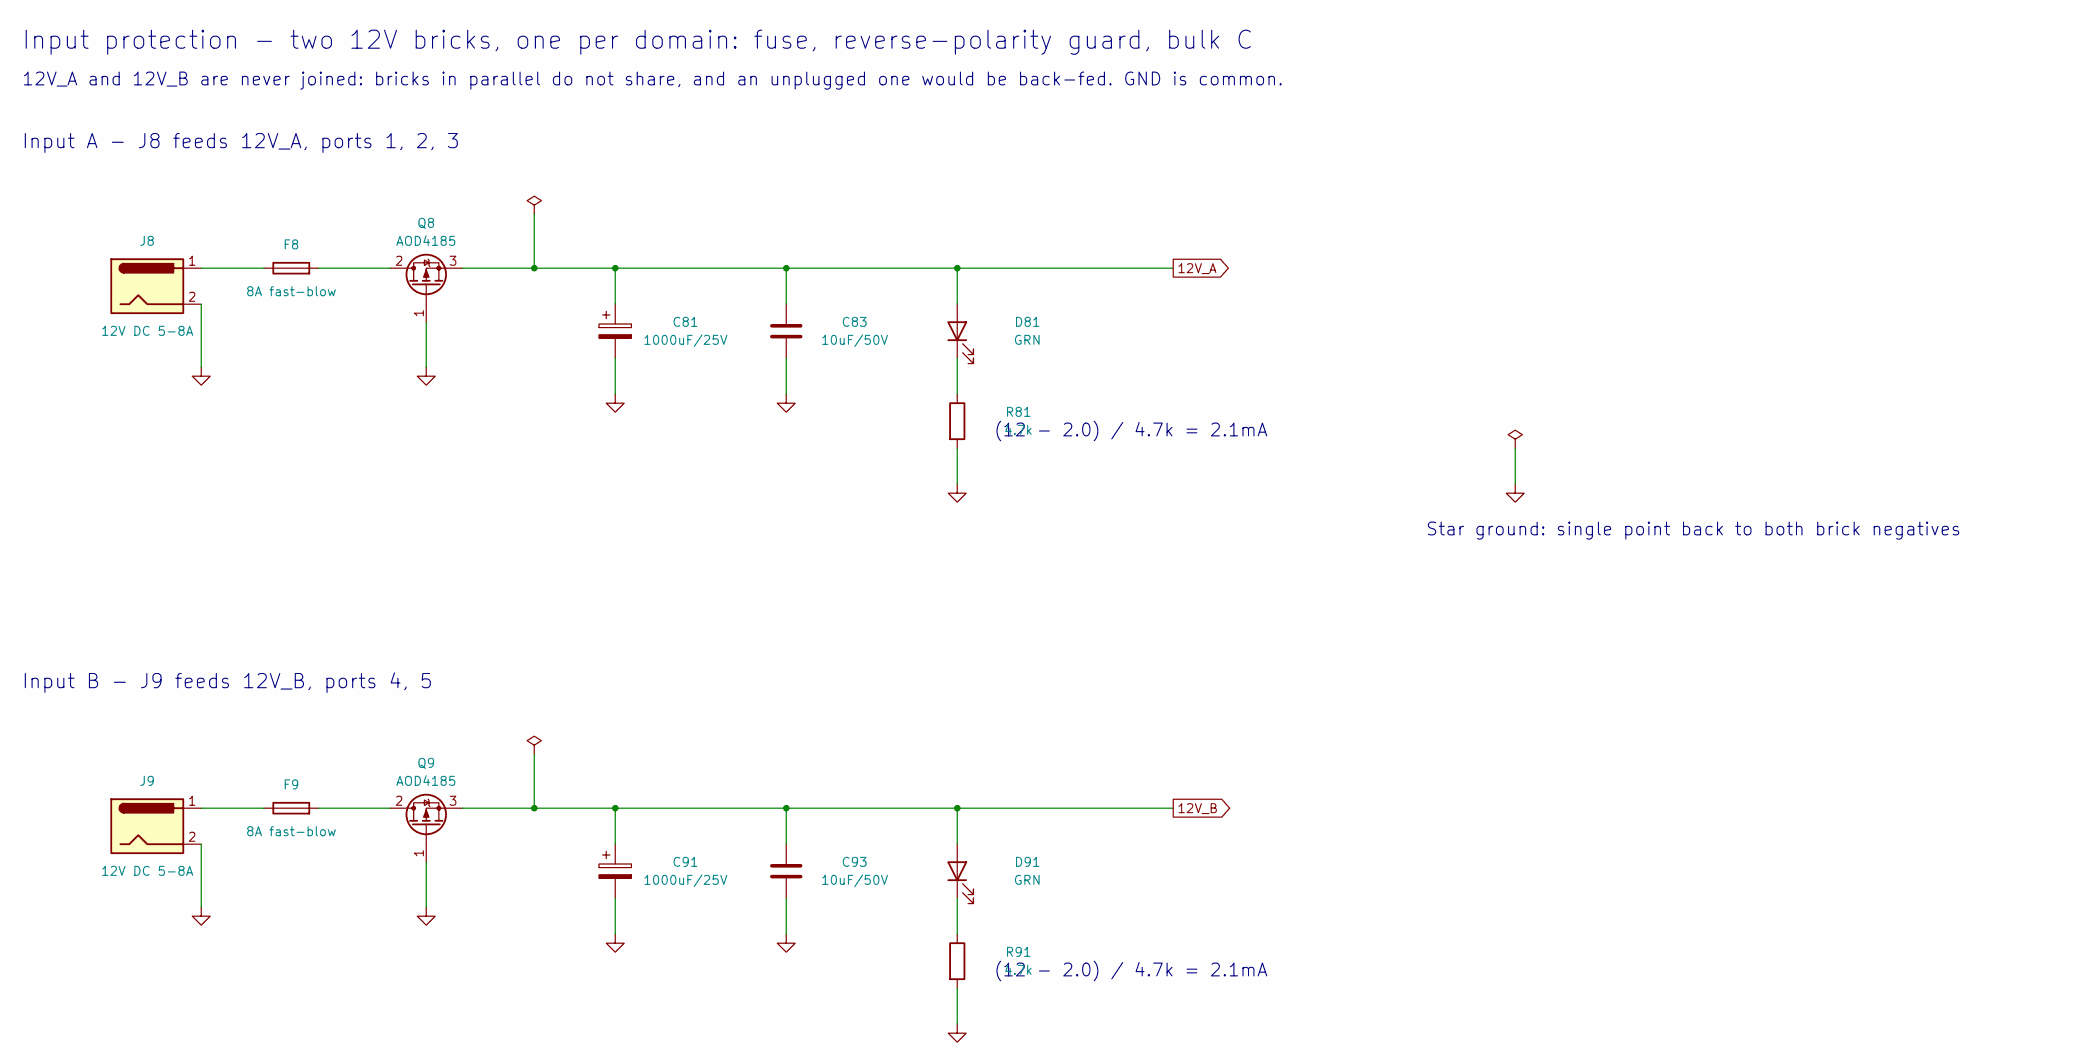
[picture p10: schematic sata_psu_input.kicad_sch, Input protection]

Parts:
C81, C91: 1000uF/25V; CP_Radial_D10.0mm_P5.00mm; MPN UVR1E102MPD; DigiKey 493-1065-ND
C83, C93: 10uF/50V; C_1206_3216Metric; MPN CL31A106KBHNNNE; DigiKey 1276-2876-1-ND
D81, D91: GRN; LED_0603_1608Metric
F8, F9: 8A fast-blow; Fuseholder_Clip-5x20mm_Bel_FC-203-22_Lateral_P17.80x5.00mm_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; MPN FC-203-22; DigiKey 507-1703-ND
J8, J9: 12V DC 5-8A; BarrelJack_CUI_PJ-063AH_Horizontal; MPN PJ-063AH; DigiKey CP-063AH-ND
Q8, Q9: AOD4185; TO-252-3_TabPin2; MPN AOD4185; DigiKey 785-1222-2-ND
R81, R91: 4.7k; R_0603_1608Metric

Connections:
12V_A: C81.1, C83.1, D81.2 (A), Q8.3 (S); also elsewhere on the board
12V_B: C91.1, C93.1, D91.2 (A), Q9.3 (S); also elsewhere on the board
GND: C81.2, C83.2, C91.2, C93.2, J8.2, J9.2, Q8.1 (G), Q9.1 (G), R81.2, R91.2; also elsewhere on the board
unnamed: D81.1 (K), R81.1
unnamed: D91.1 (K), R91.1
unnamed: F8.1, J8.1
unnamed: F9.1, J9.1
unnamed: F8.2, Q8.2 (D)
unnamed: F9.2, Q9.2 (D)

Notes on the sheet:
Input protection - two 12V bricks, one per domain: fuse, reverse-polarity guard, bulk C
12V_A and 12V_B are never joined: bricks in parallel do not share, and an unplugged one would be back-fed. GND is common.
Input A - J8 feeds 12V_A, ports 1, 2, 3
(12 - 2.0) / 4.7k = 2.1mA
Input B - J9 feeds 12V_B, ports 4, 5
Star ground: single point back to both brick negatives

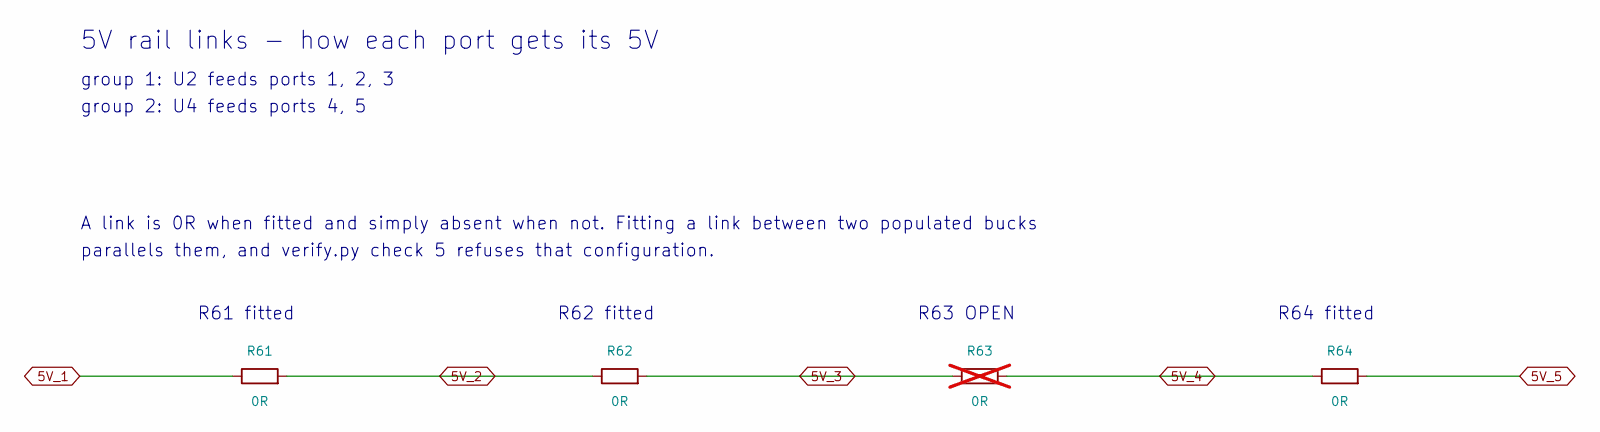
[picture p11: schematic sata_psu_rails.kicad_sch, 5V rail links]

Parts:
R61, R62, R64: 0R; R_1206_3216Metric
R63: 0R; R_1206_3216Metric; not fitted

Connections:
5V_1: R61.1; also elsewhere on the board
5V_2: R61.2, R62.1; also elsewhere on the board
5V_3: R62.2, R63.1; also elsewhere on the board
5V_4: R63.2, R64.1; also elsewhere on the board
5V_5: R64.2; also elsewhere on the board

Notes on the sheet:
5V rail links - how each port gets its 5V
group 1: U2 feeds ports 1, 2, 3
group 2: U4 feeds ports 4, 5
A link is 0R when fitted and simply absent when not. Fitting a link between two populated bucks
parallels them, and verify.py check 5 refuses that configuration.
R61 fitted
R62 fitted
R63 OPEN
R64 fitted

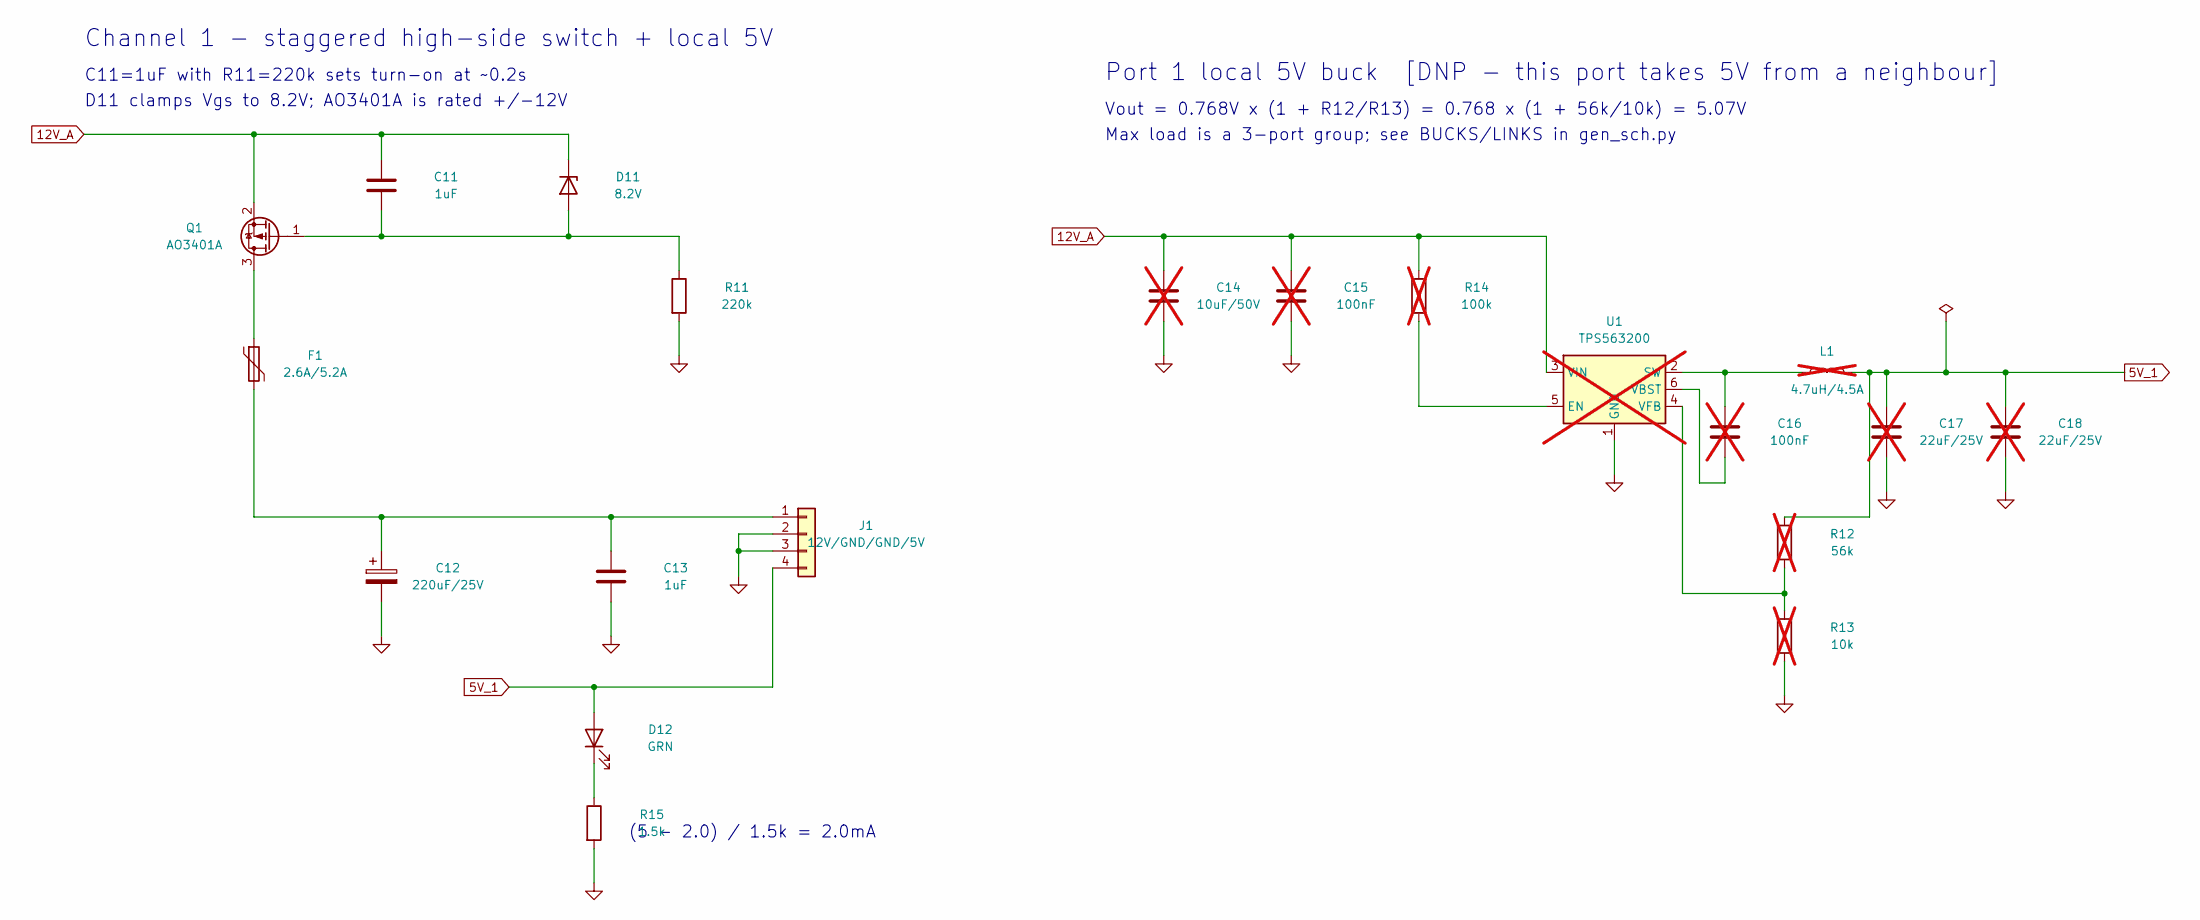
[picture p12: schematic sata_psu_channel1.kicad_sch, Channel 1]

Parts:
C11, C13: 1uF; C_0603_1608Metric; MPN CL10A105KB8NNNC; DigiKey 1276-1860-1-ND
C12: 220uF/25V; CP_Radial_D8.0mm_P3.50mm; MPN UVZ1E221MPD; DigiKey 493-1302-ND
C14: 10uF/50V; C_1206_3216Metric; MPN CL31A106KBHNNNE; DigiKey 1276-2876-1-ND; not fitted
C15, C16: 100nF; C_0603_1608Metric; MPN CL10B104KB8NNNC; DigiKey 1276-1000-1-ND; not fitted
C17, C18: 22uF/25V; C_1206_3216Metric; MPN CL31A226KAHNNNE; DigiKey 1276-3047-1-ND; not fitted
D11: 8.2V; D_SOD-123; MPN MMSZ5237B-7-F; DigiKey MMSZ5237B-FDICT-ND
D12: GRN; LED_0603_1608Metric
F1: 2.6A/5.2A; Fuse_1812_4532Metric; MPN 1812L260/16MR; DigiKey F10827CT-ND
J1: 12V/GND/GND/5V; PinHeader_1x04_P2.54mm_Vertical; MPN PRPC004SAAN-RC; DigiKey S1011EC-04-ND
L1: 4.7uH/4.5A; L_Bourns_SRN6045TA; MPN SRN6045TA-4R7M; DigiKey SRN6045TA-4R7MTR-ND; not fitted
Q1: AO3401A; SOT-23; MPN AO3401A; DigiKey 785-1001-1-ND
R11: 220k; R_0603_1608Metric; MPN RC0603FR-07220KL; DigiKey 311-220KHRCT-ND
R12: 56k; R_0603_1608Metric; MPN RC0603FR-0756KL; DigiKey 311-56KHRCT-ND; not fitted
R13: 10k; R_0603_1608Metric; MPN RC0603FR-0710KL; DigiKey 311-10.0KHRCT-ND; not fitted
R14: 100k; R_0603_1608Metric; MPN RC0603FR-07100KL; DigiKey 311-100KHRCT-ND; not fitted
R15: 1.5k; R_0603_1608Metric
U1: TPS563200; SOT-23-6; MPN TPS563200DDCR; DigiKey 296-43663-1-ND; not fitted

Connections:
5V_1: C17.1, C18.1, D12.2 (A), J1.4, L1.2, R12.1; also elsewhere on the board
12V_A: C11.1, C14.1, C15.1, D11.1 (K), Q1.2 (S), R14.1, U1.3 (VIN); also elsewhere on the board
GND: C12.2, C13.2, C14.2, C15.2, C17.2, C18.2, J1.2, J1.3, R11.2, R13.2, R15.2, U1.1 (GND); also elsewhere on the board
unnamed: C11.2, D11.2 (A), Q1.1 (G), R11.1
unnamed: D12.1 (K), R15.1
unnamed: C12.1, C13.1, F1.2, J1.1
unnamed: F1.1, Q1.3 (D)
unnamed: R14.2, U1.5 (EN)
unnamed: C16.1, L1.1, U1.2 (SW)
unnamed: C16.2, U1.6 (VBST)
unnamed: R12.2, R13.1, U1.4 (VFB)

Notes on the sheet:
Channel 1 - staggered high-side switch + local 5V
C11=1uF with R11=220k sets turn-on at ~0.2s
D11 clamps Vgs to 8.2V; AO3401A is rated +/-12V
(5 - 2.0) / 1.5k = 2.0mA
Port 1 local 5V buck [DNP - this port takes 5V from a neighbour]
Vout = 0.768V x (1 + R12/R13) = 0.768 x (1 + 56k/10k) = 5.07V
Max load is a 3-port group; see BUCKS/LINKS in gen_sch.py

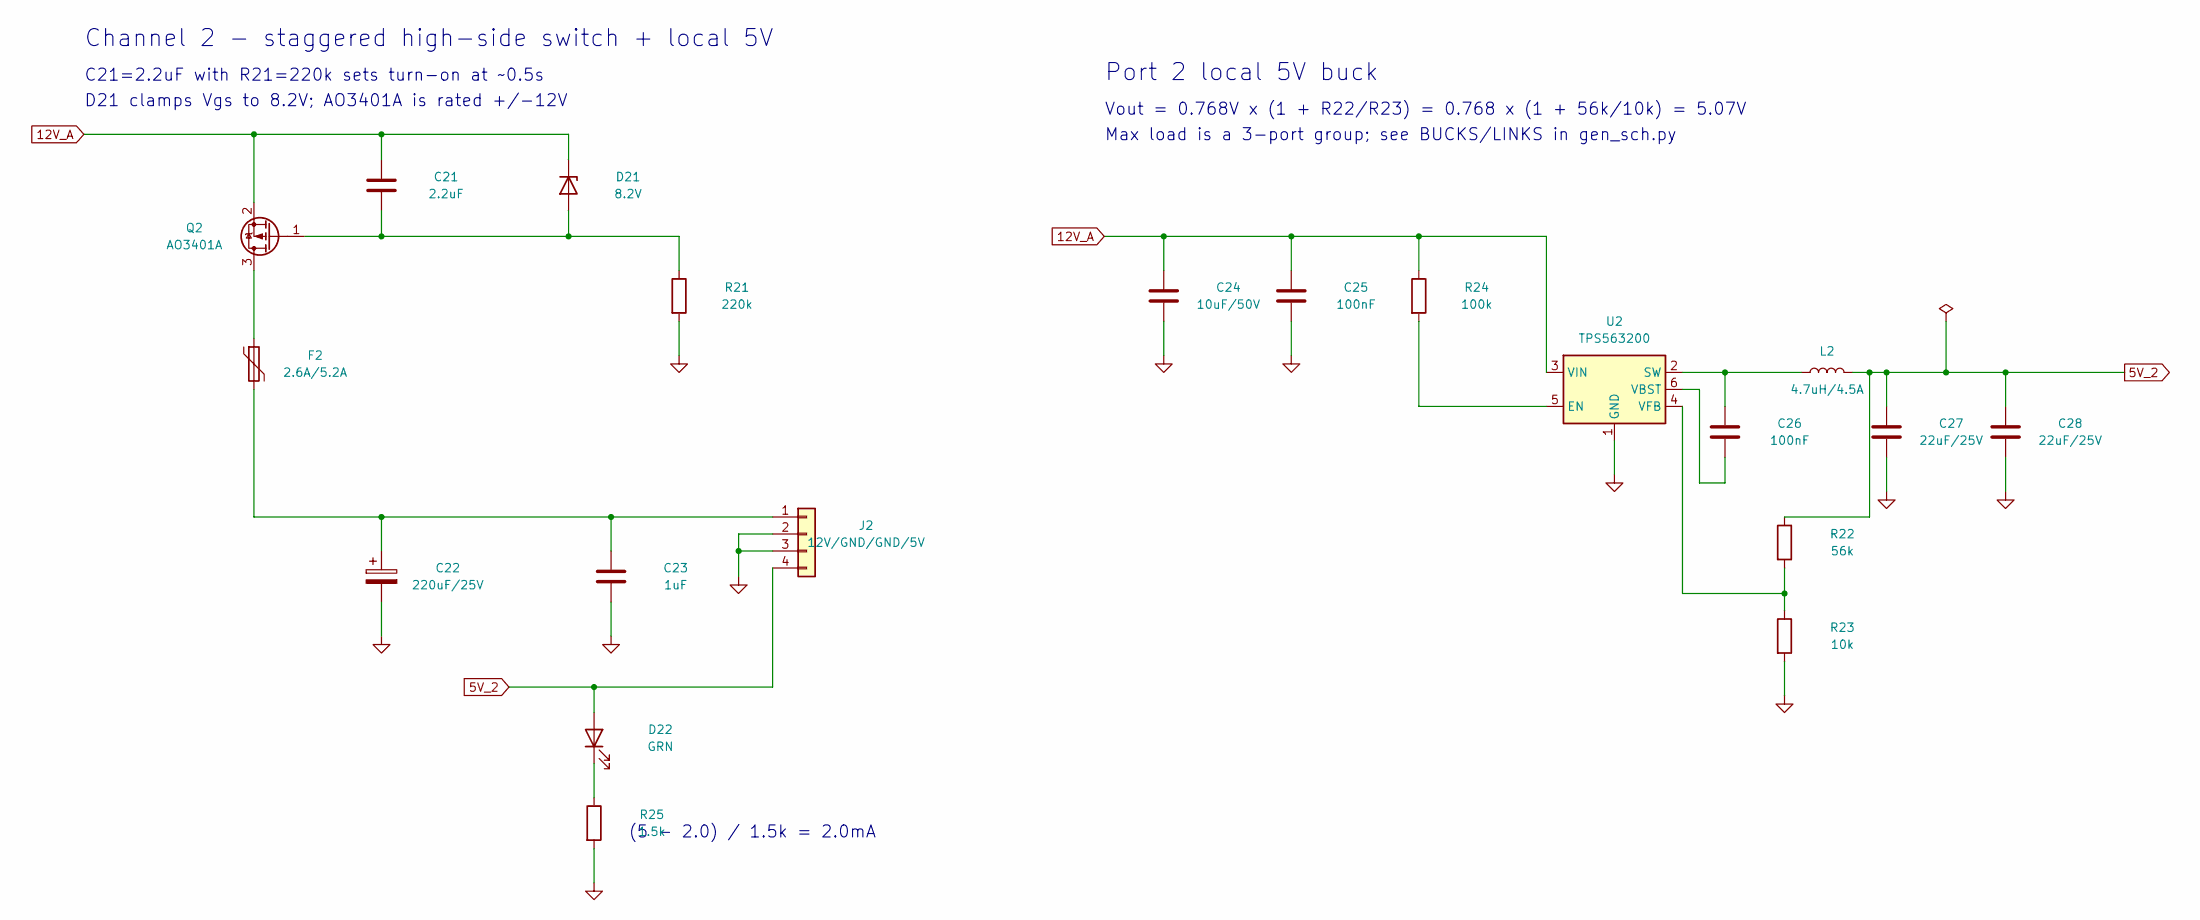
[picture p13: schematic sata_psu_channel2.kicad_sch, Channel 2]

Parts:
C21: 2.2uF; C_0603_1608Metric; MPN CL10A225KO8NNNC; DigiKey 1276-1040-1-ND
C22: 220uF/25V; CP_Radial_D8.0mm_P3.50mm; MPN UVZ1E221MPD; DigiKey 493-1302-ND
C23: 1uF; C_0603_1608Metric; MPN CL10A105KB8NNNC; DigiKey 1276-1860-1-ND
C24: 10uF/50V; C_1206_3216Metric; MPN CL31A106KBHNNNE; DigiKey 1276-2876-1-ND
C25, C26: 100nF; C_0603_1608Metric; MPN CL10B104KB8NNNC; DigiKey 1276-1000-1-ND
C27, C28: 22uF/25V; C_1206_3216Metric; MPN CL31A226KAHNNNE; DigiKey 1276-3047-1-ND
D21: 8.2V; D_SOD-123; MPN MMSZ5237B-7-F; DigiKey MMSZ5237B-FDICT-ND
D22: GRN; LED_0603_1608Metric
F2: 2.6A/5.2A; Fuse_1812_4532Metric; MPN 1812L260/16MR; DigiKey F10827CT-ND
J2: 12V/GND/GND/5V; PinHeader_1x04_P2.54mm_Vertical; MPN PRPC004SAAN-RC; DigiKey S1011EC-04-ND
L2: 4.7uH/4.5A; L_Bourns_SRN6045TA; MPN SRN6045TA-4R7M; DigiKey SRN6045TA-4R7MTR-ND
Q2: AO3401A; SOT-23; MPN AO3401A; DigiKey 785-1001-1-ND
R21: 220k; R_0603_1608Metric; MPN RC0603FR-07220KL; DigiKey 311-220KHRCT-ND
R22: 56k; R_0603_1608Metric; MPN RC0603FR-0756KL; DigiKey 311-56KHRCT-ND
R23: 10k; R_0603_1608Metric; MPN RC0603FR-0710KL; DigiKey 311-10.0KHRCT-ND
R24: 100k; R_0603_1608Metric; MPN RC0603FR-07100KL; DigiKey 311-100KHRCT-ND
R25: 1.5k; R_0603_1608Metric
U2: TPS563200; SOT-23-6; MPN TPS563200DDCR; DigiKey 296-43663-1-ND

Connections:
5V_2: C27.1, C28.1, D22.2 (A), J2.4, L2.2, R22.1; also elsewhere on the board
12V_A: C21.1, C24.1, C25.1, D21.1 (K), Q2.2 (S), R24.1, U2.3 (VIN); also elsewhere on the board
GND: C22.2, C23.2, C24.2, C25.2, C27.2, C28.2, J2.2, J2.3, R21.2, R23.2, R25.2, U2.1 (GND); also elsewhere on the board
unnamed: C21.2, D21.2 (A), Q2.1 (G), R21.1
unnamed: D22.1 (K), R25.1
unnamed: C22.1, C23.1, F2.2, J2.1
unnamed: F2.1, Q2.3 (D)
unnamed: R24.2, U2.5 (EN)
unnamed: C26.1, L2.1, U2.2 (SW)
unnamed: C26.2, U2.6 (VBST)
unnamed: R22.2, R23.1, U2.4 (VFB)

Notes on the sheet:
Channel 2 - staggered high-side switch + local 5V
C21=2.2uF with R21=220k sets turn-on at ~0.5s
D21 clamps Vgs to 8.2V; AO3401A is rated +/-12V
(5 - 2.0) / 1.5k = 2.0mA
Port 2 local 5V buck
Vout = 0.768V x (1 + R22/R23) = 0.768 x (1 + 56k/10k) = 5.07V
Max load is a 3-port group; see BUCKS/LINKS in gen_sch.py

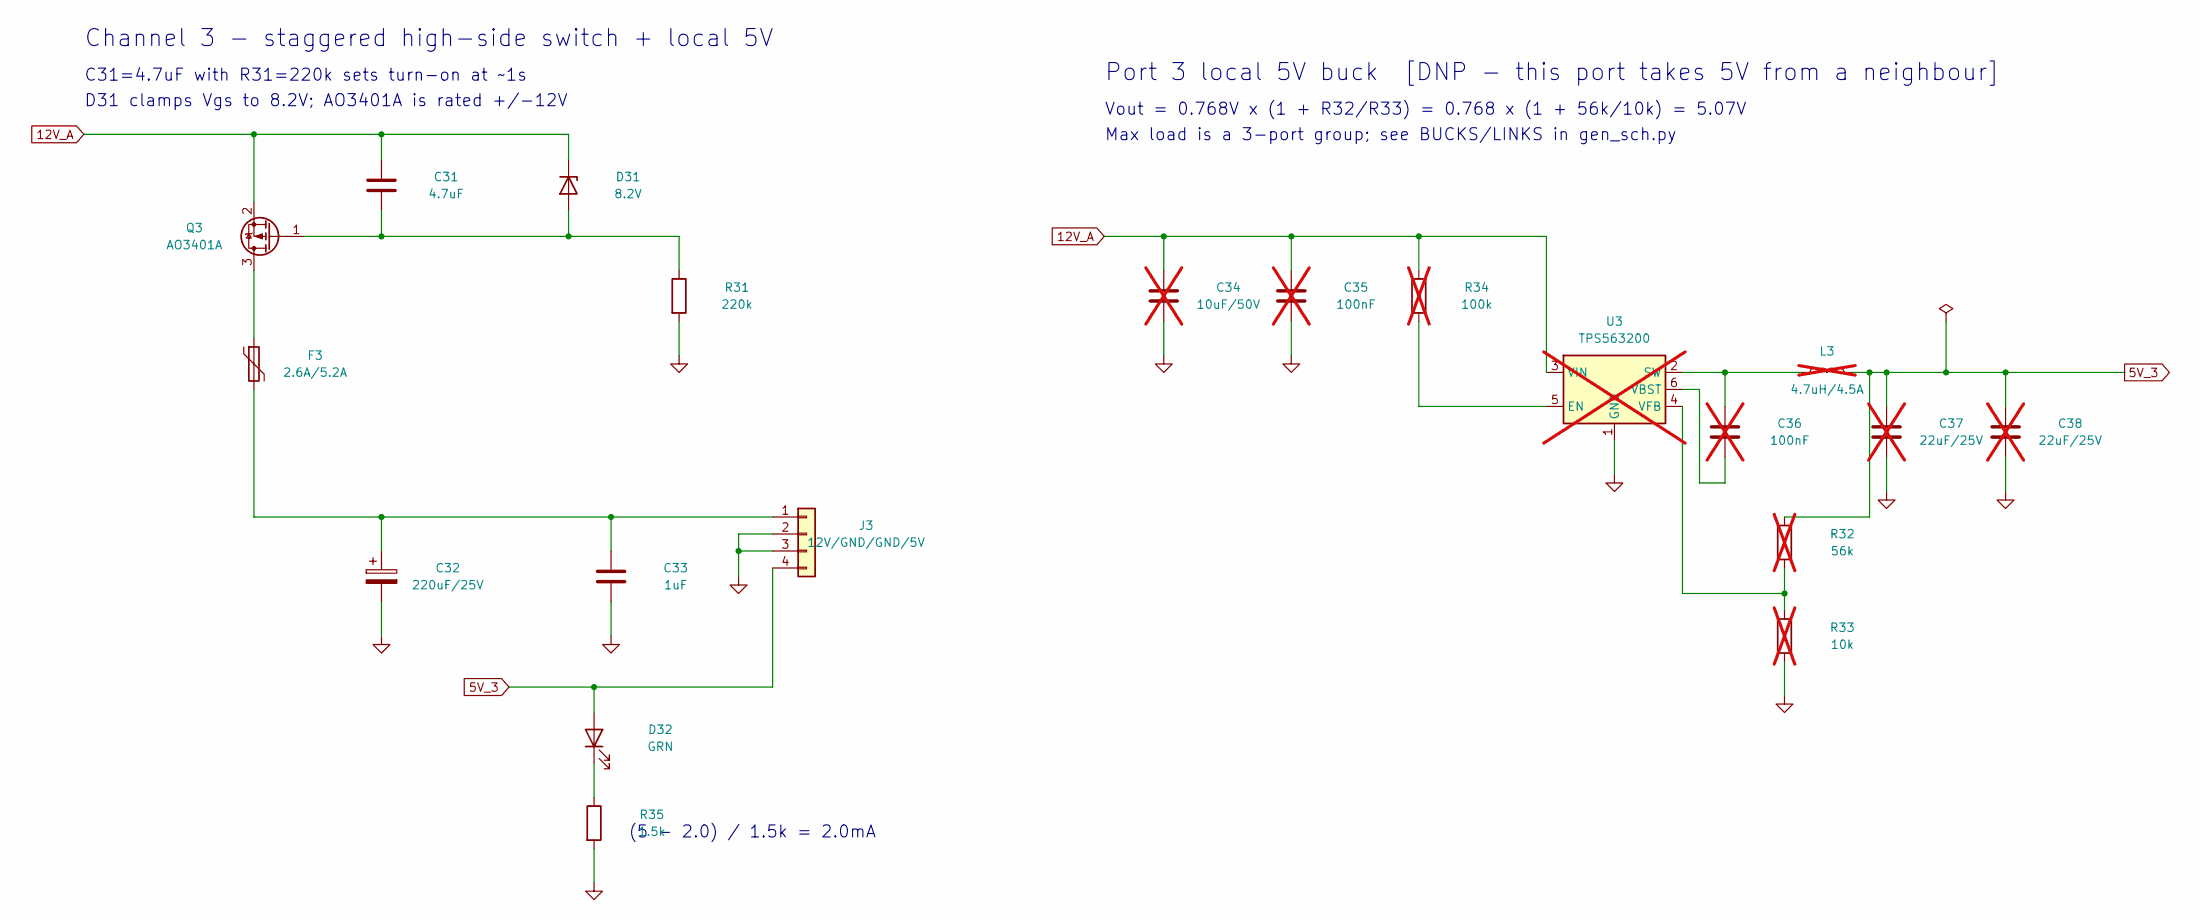
[picture p14: schematic sata_psu_channel3.kicad_sch, Channel 3]

Parts:
C31: 4.7uF; C_0603_1608Metric; MPN CL10A475KO8NNNC; DigiKey 1276-1784-1-ND
C32: 220uF/25V; CP_Radial_D8.0mm_P3.50mm; MPN UVZ1E221MPD; DigiKey 493-1302-ND
C33: 1uF; C_0603_1608Metric; MPN CL10A105KB8NNNC; DigiKey 1276-1860-1-ND
C34: 10uF/50V; C_1206_3216Metric; MPN CL31A106KBHNNNE; DigiKey 1276-2876-1-ND; not fitted
C35, C36: 100nF; C_0603_1608Metric; MPN CL10B104KB8NNNC; DigiKey 1276-1000-1-ND; not fitted
C37, C38: 22uF/25V; C_1206_3216Metric; MPN CL31A226KAHNNNE; DigiKey 1276-3047-1-ND; not fitted
D31: 8.2V; D_SOD-123; MPN MMSZ5237B-7-F; DigiKey MMSZ5237B-FDICT-ND
D32: GRN; LED_0603_1608Metric
F3: 2.6A/5.2A; Fuse_1812_4532Metric; MPN 1812L260/16MR; DigiKey F10827CT-ND
J3: 12V/GND/GND/5V; PinHeader_1x04_P2.54mm_Vertical; MPN PRPC004SAAN-RC; DigiKey S1011EC-04-ND
L3: 4.7uH/4.5A; L_Bourns_SRN6045TA; MPN SRN6045TA-4R7M; DigiKey SRN6045TA-4R7MTR-ND; not fitted
Q3: AO3401A; SOT-23; MPN AO3401A; DigiKey 785-1001-1-ND
R31: 220k; R_0603_1608Metric; MPN RC0603FR-07220KL; DigiKey 311-220KHRCT-ND
R32: 56k; R_0603_1608Metric; MPN RC0603FR-0756KL; DigiKey 311-56KHRCT-ND; not fitted
R33: 10k; R_0603_1608Metric; MPN RC0603FR-0710KL; DigiKey 311-10.0KHRCT-ND; not fitted
R34: 100k; R_0603_1608Metric; MPN RC0603FR-07100KL; DigiKey 311-100KHRCT-ND; not fitted
R35: 1.5k; R_0603_1608Metric
U3: TPS563200; SOT-23-6; MPN TPS563200DDCR; DigiKey 296-43663-1-ND; not fitted

Connections:
5V_3: C37.1, C38.1, D32.2 (A), J3.4, L3.2, R32.1; also elsewhere on the board
12V_A: C31.1, C34.1, C35.1, D31.1 (K), Q3.2 (S), R34.1, U3.3 (VIN); also elsewhere on the board
GND: C32.2, C33.2, C34.2, C35.2, C37.2, C38.2, J3.2, J3.3, R31.2, R33.2, R35.2, U3.1 (GND); also elsewhere on the board
unnamed: C31.2, D31.2 (A), Q3.1 (G), R31.1
unnamed: D32.1 (K), R35.1
unnamed: C32.1, C33.1, F3.2, J3.1
unnamed: F3.1, Q3.3 (D)
unnamed: R34.2, U3.5 (EN)
unnamed: C36.1, L3.1, U3.2 (SW)
unnamed: C36.2, U3.6 (VBST)
unnamed: R32.2, R33.1, U3.4 (VFB)

Notes on the sheet:
Channel 3 - staggered high-side switch + local 5V
C31=4.7uF with R31=220k sets turn-on at ~1s
D31 clamps Vgs to 8.2V; AO3401A is rated +/-12V
(5 - 2.0) / 1.5k = 2.0mA
Port 3 local 5V buck [DNP - this port takes 5V from a neighbour]
Vout = 0.768V x (1 + R32/R33) = 0.768 x (1 + 56k/10k) = 5.07V
Max load is a 3-port group; see BUCKS/LINKS in gen_sch.py

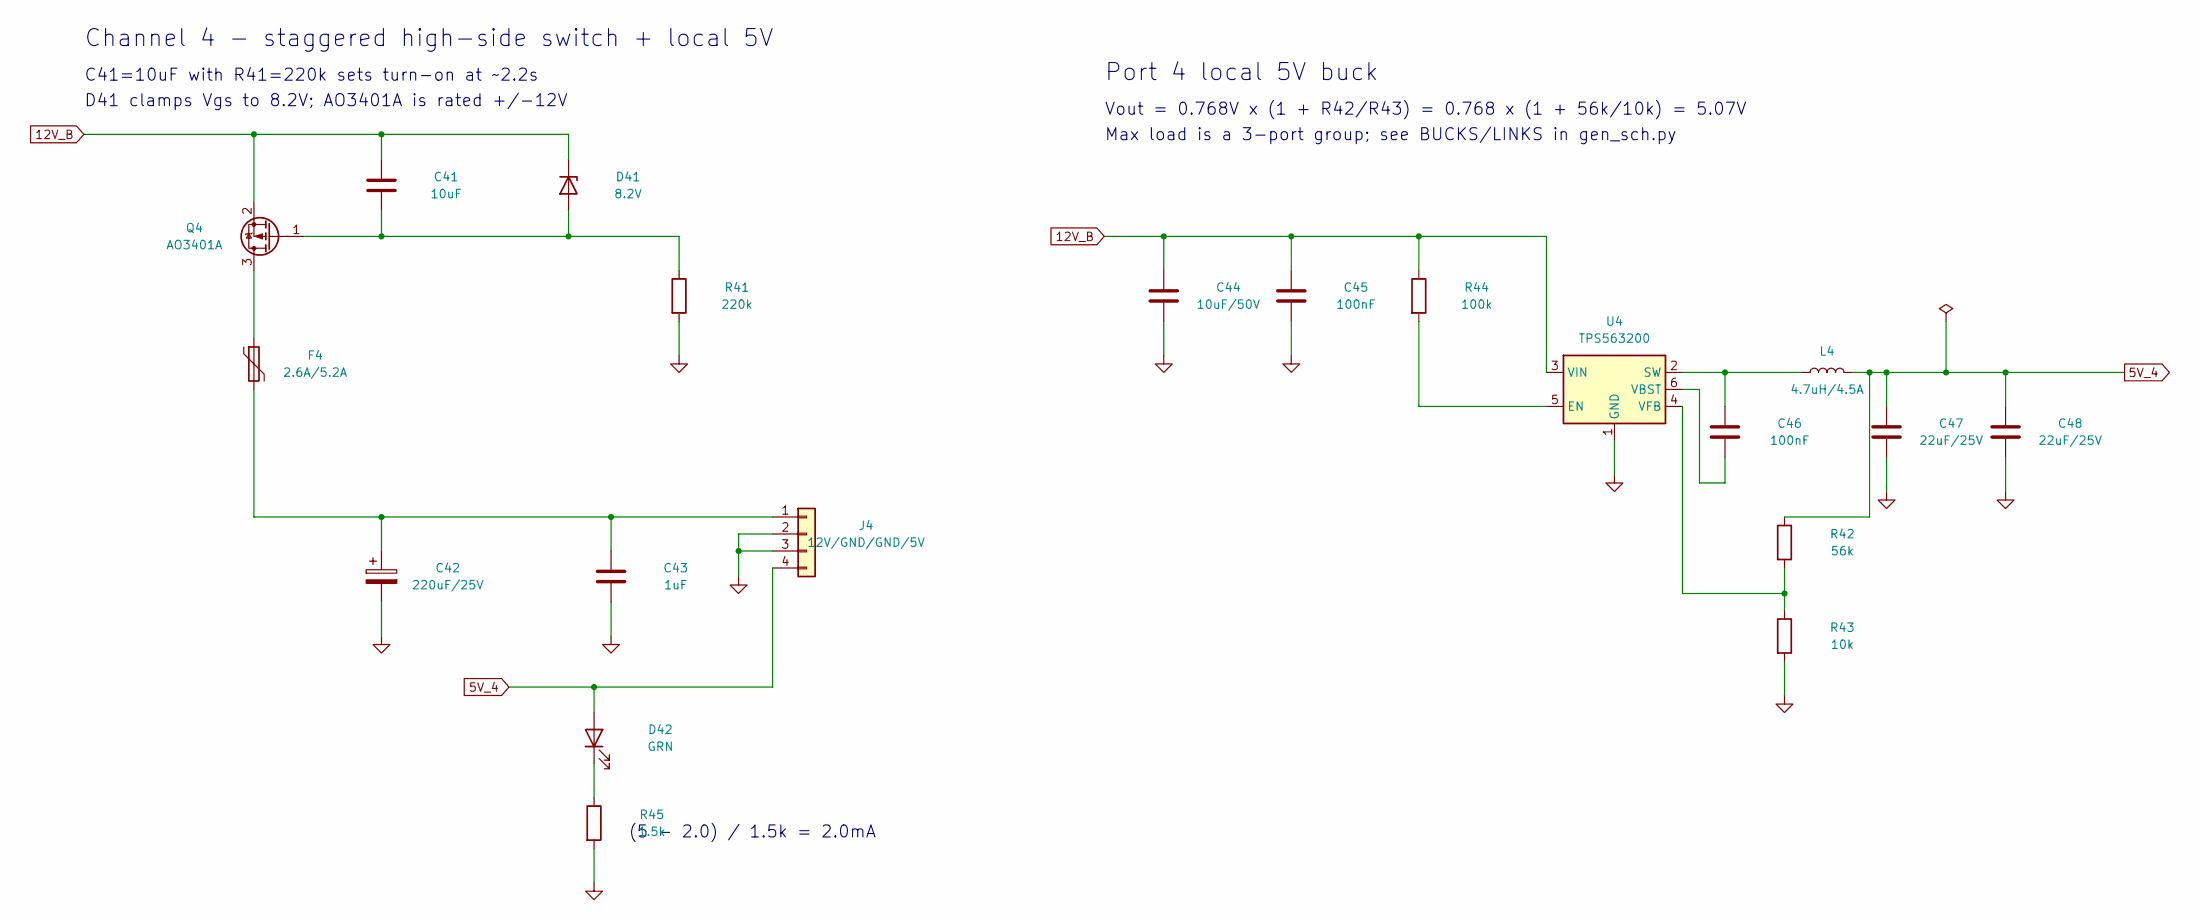
[picture p15: schematic sata_psu_channel4.kicad_sch, Channel 4]

Parts:
C41: 10uF; C_1206_3216Metric; MPN CL31A106KBHNNNE; DigiKey 1276-2876-1-ND
C42: 220uF/25V; CP_Radial_D8.0mm_P3.50mm; MPN UVZ1E221MPD; DigiKey 493-1302-ND
C43: 1uF; C_0603_1608Metric; MPN CL10A105KB8NNNC; DigiKey 1276-1860-1-ND
C44: 10uF/50V; C_1206_3216Metric; MPN CL31A106KBHNNNE; DigiKey 1276-2876-1-ND
C45, C46: 100nF; C_0603_1608Metric; MPN CL10B104KB8NNNC; DigiKey 1276-1000-1-ND
C47, C48: 22uF/25V; C_1206_3216Metric; MPN CL31A226KAHNNNE; DigiKey 1276-3047-1-ND
D41: 8.2V; D_SOD-123; MPN MMSZ5237B-7-F; DigiKey MMSZ5237B-FDICT-ND
D42: GRN; LED_0603_1608Metric
F4: 2.6A/5.2A; Fuse_1812_4532Metric; MPN 1812L260/16MR; DigiKey F10827CT-ND
J4: 12V/GND/GND/5V; PinHeader_1x04_P2.54mm_Vertical; MPN PRPC004SAAN-RC; DigiKey S1011EC-04-ND
L4: 4.7uH/4.5A; L_Bourns_SRN6045TA; MPN SRN6045TA-4R7M; DigiKey SRN6045TA-4R7MTR-ND
Q4: AO3401A; SOT-23; MPN AO3401A; DigiKey 785-1001-1-ND
R41: 220k; R_0603_1608Metric; MPN RC0603FR-07220KL; DigiKey 311-220KHRCT-ND
R42: 56k; R_0603_1608Metric; MPN RC0603FR-0756KL; DigiKey 311-56KHRCT-ND
R43: 10k; R_0603_1608Metric; MPN RC0603FR-0710KL; DigiKey 311-10.0KHRCT-ND
R44: 100k; R_0603_1608Metric; MPN RC0603FR-07100KL; DigiKey 311-100KHRCT-ND
R45: 1.5k; R_0603_1608Metric
U4: TPS563200; SOT-23-6; MPN TPS563200DDCR; DigiKey 296-43663-1-ND

Connections:
5V_4: C47.1, C48.1, D42.2 (A), J4.4, L4.2, R42.1; also elsewhere on the board
12V_B: C41.1, C44.1, C45.1, D41.1 (K), Q4.2 (S), R44.1, U4.3 (VIN); also elsewhere on the board
GND: C42.2, C43.2, C44.2, C45.2, C47.2, C48.2, J4.2, J4.3, R41.2, R43.2, R45.2, U4.1 (GND); also elsewhere on the board
unnamed: C41.2, D41.2 (A), Q4.1 (G), R41.1
unnamed: D42.1 (K), R45.1
unnamed: C42.1, C43.1, F4.2, J4.1
unnamed: F4.1, Q4.3 (D)
unnamed: R44.2, U4.5 (EN)
unnamed: C46.1, L4.1, U4.2 (SW)
unnamed: C46.2, U4.6 (VBST)
unnamed: R42.2, R43.1, U4.4 (VFB)

Notes on the sheet:
Channel 4 - staggered high-side switch + local 5V
C41=10uF with R41=220k sets turn-on at ~2.2s
D41 clamps Vgs to 8.2V; AO3401A is rated +/-12V
(5 - 2.0) / 1.5k = 2.0mA
Port 4 local 5V buck
Vout = 0.768V x (1 + R42/R43) = 0.768 x (1 + 56k/10k) = 5.07V
Max load is a 3-port group; see BUCKS/LINKS in gen_sch.py

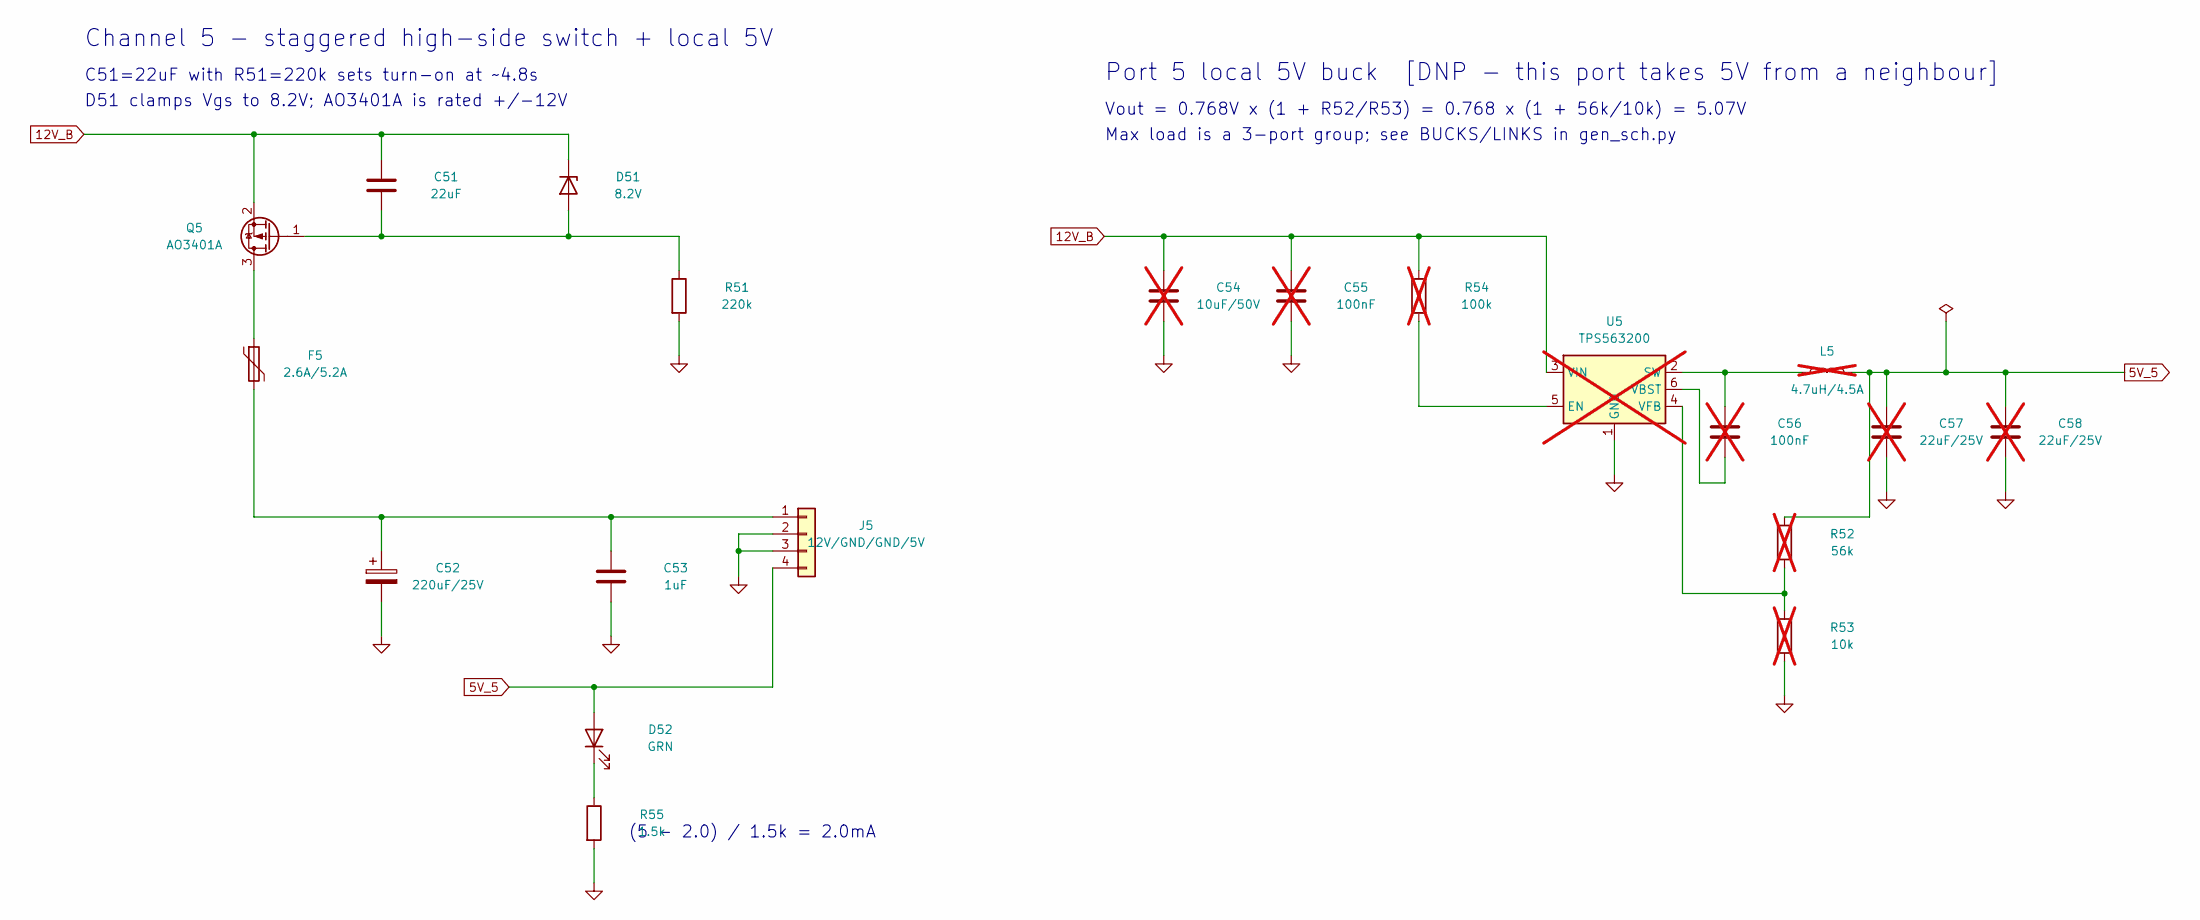
[picture p16: schematic sata_psu_channel5.kicad_sch, Channel 5]

Parts:
C51: 22uF; C_1206_3216Metric; MPN CL31A226KAHNNNE; DigiKey 1276-3047-1-ND
C52: 220uF/25V; CP_Radial_D8.0mm_P3.50mm; MPN UVZ1E221MPD; DigiKey 493-1302-ND
C53: 1uF; C_0603_1608Metric; MPN CL10A105KB8NNNC; DigiKey 1276-1860-1-ND
C54: 10uF/50V; C_1206_3216Metric; MPN CL31A106KBHNNNE; DigiKey 1276-2876-1-ND; not fitted
C55, C56: 100nF; C_0603_1608Metric; MPN CL10B104KB8NNNC; DigiKey 1276-1000-1-ND; not fitted
C57, C58: 22uF/25V; C_1206_3216Metric; MPN CL31A226KAHNNNE; DigiKey 1276-3047-1-ND; not fitted
D51: 8.2V; D_SOD-123; MPN MMSZ5237B-7-F; DigiKey MMSZ5237B-FDICT-ND
D52: GRN; LED_0603_1608Metric
F5: 2.6A/5.2A; Fuse_1812_4532Metric; MPN 1812L260/16MR; DigiKey F10827CT-ND
J5: 12V/GND/GND/5V; PinHeader_1x04_P2.54mm_Vertical; MPN PRPC004SAAN-RC; DigiKey S1011EC-04-ND
L5: 4.7uH/4.5A; L_Bourns_SRN6045TA; MPN SRN6045TA-4R7M; DigiKey SRN6045TA-4R7MTR-ND; not fitted
Q5: AO3401A; SOT-23; MPN AO3401A; DigiKey 785-1001-1-ND
R51: 220k; R_0603_1608Metric; MPN RC0603FR-07220KL; DigiKey 311-220KHRCT-ND
R52: 56k; R_0603_1608Metric; MPN RC0603FR-0756KL; DigiKey 311-56KHRCT-ND; not fitted
R53: 10k; R_0603_1608Metric; MPN RC0603FR-0710KL; DigiKey 311-10.0KHRCT-ND; not fitted
R54: 100k; R_0603_1608Metric; MPN RC0603FR-07100KL; DigiKey 311-100KHRCT-ND; not fitted
R55: 1.5k; R_0603_1608Metric
U5: TPS563200; SOT-23-6; MPN TPS563200DDCR; DigiKey 296-43663-1-ND; not fitted

Connections:
5V_5: C57.1, C58.1, D52.2 (A), J5.4, L5.2, R52.1; also elsewhere on the board
12V_B: C51.1, C54.1, C55.1, D51.1 (K), Q5.2 (S), R54.1, U5.3 (VIN); also elsewhere on the board
GND: C52.2, C53.2, C54.2, C55.2, C57.2, C58.2, J5.2, J5.3, R51.2, R53.2, R55.2, U5.1 (GND); also elsewhere on the board
unnamed: C51.2, D51.2 (A), Q5.1 (G), R51.1
unnamed: D52.1 (K), R55.1
unnamed: C52.1, C53.1, F5.2, J5.1
unnamed: F5.1, Q5.3 (D)
unnamed: R54.2, U5.5 (EN)
unnamed: C56.1, L5.1, U5.2 (SW)
unnamed: C56.2, U5.6 (VBST)
unnamed: R52.2, R53.1, U5.4 (VFB)

Notes on the sheet:
Channel 5 - staggered high-side switch + local 5V
C51=22uF with R51=220k sets turn-on at ~4.8s
D51 clamps Vgs to 8.2V; AO3401A is rated +/-12V
(5 - 2.0) / 1.5k = 2.0mA
Port 5 local 5V buck [DNP - this port takes 5V from a neighbour]
Vout = 0.768V x (1 + R52/R53) = 0.768 x (1 + 56k/10k) = 5.07V
Max load is a 3-port group; see BUCKS/LINKS in gen_sch.py

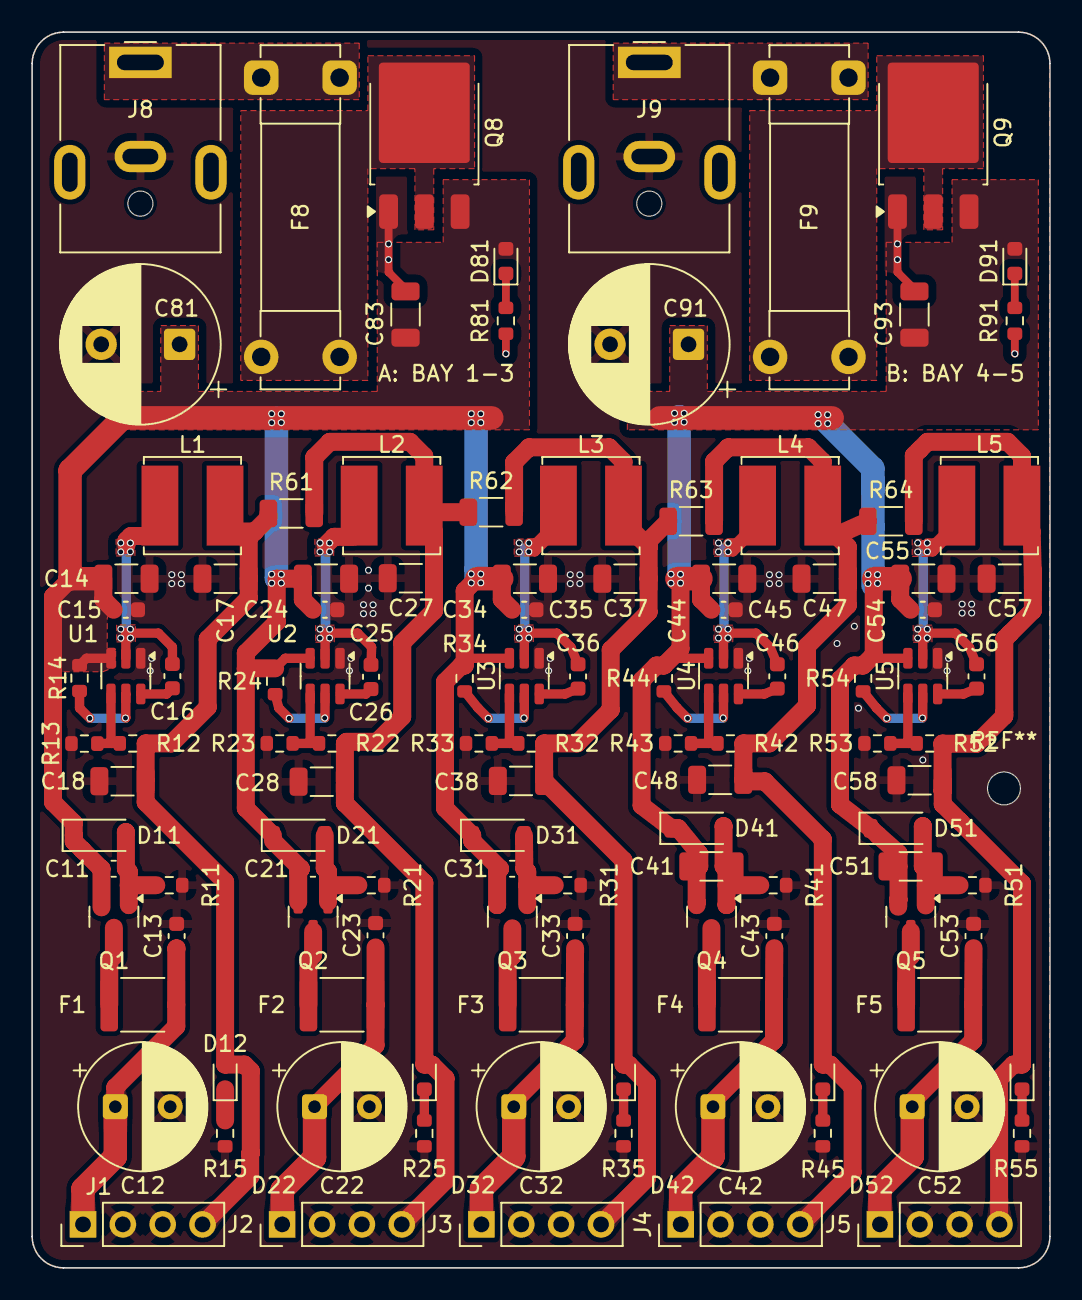
[picture p17: board sata_psu.kicad_pcb from above]

Board: 2 copper layers, 64.9 x 78.8 mm, 118 parts (0 on the bottom side), 54 nets.
