mattibmt98/Sata-Multiplier-power-supply/(commit log)

2026-09-06 v1: 5-bay SATA PSU — generated KiCad 9 project
    Single 12V brick in, five staggered 12V+5V drive outputs out. Per-channel
    high-side PMOS with an RC gate network spreads the drives' spin-up inrush
    over ~5s; onboard TPS563200 buck makes the shared 5V rail; no 3.3V pin
    anywhere, so SATA PWDIS cannot bite.
    The schematic and the PCB placement are both generated from Python
    (gen_sch.py / gen_pcb.py) and cross-checked against an independently
    written SKiDL netlist. Schematic verified (ERC clean, netlist equivalent,
    pins match pads); board placed at 64.2 x 53.3 mm with 0 DRC violations.
    Routing not started.
    [bom.csv, sata_psu.kicad_pcb, sata_psu.kicad_sch, sata_psu_buck.kicad_sch, sata_psu_channel1.kicad_sch, sata_psu_channel2.kicad_sch, sata_psu_channel3.kicad_sch, sata_psu_channel4.kicad_sch]
2026-09-06 v2: per-port 5V buck with 0R neighbour sharing, plus rail indicators
    Every port now has its own local 5V node and its own buck footprint, with
    adjacent nodes joined by 0R links (R61-R64). How a port gets its 5V is a
    populate choice rather than a layout one -- BUCKS/LINKS at the top of
    gen_sch.py is the whole configuration, and the lands are always present.
    This closes v1's largest open issue. One 3A TPS563200 was under-rated
    against a five-bay 5V rail; capping a buck at a three-port group makes its
    worst case 2.1A and the same part is correctly sized.
    Indicators: one 12V LED on the common rail, tapped after Q8 so it also
    proves the reverse-polarity guard conducts, and one 5V LED per port o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
    [bom.csv, sata_psu.kicad_pcb, sata_psu.kicad_sch, sata_psu_buck.kicad_sch, sata_psu_channel1.kicad_sch, sata_psu_channel2.kicad_sch, sata_psu_channel3.kicad_sch, sata_psu_channel4.kicad_sch]
2026-10-20 v3: JLCPCB-ready layout, fab outputs and DigiKey BOM
    Board (DRC clean against JLCPCB standard 2-layer rules, 0 errors,
    0 unconnected, schematic parity clean):
    - design rules set to JLCPCB limits; extra pad rules in sata_psu.kicad_dru
    - buck GND pins (U1-U5) were on isolated F.Cu islands: stitched to B.Cu
    - C41/C51 1206 pads restored from 0603 pitch to library land pattern
    - replicated SW via patches re-netted (ch2/4/5), missing ones added
    - duplicate 12V zone and dangling vias on ch1 removed; 0.4 vias -> 0.45
    - gate-cap courtyards in ch4/ch5 cleared; DNP flags synced from schematic
    - refdes resized to 1.0/0.15 mm and placed clear of pads and silk
    Outputs: Gerbers + Excellon drill (gerbers/,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
    [digikey_bom.csv, digikey_cart_upload.csv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]
2026-11-10 v4: two 12V inputs, load split across two barrel jacks
    A fully populated cage pulls more than one PJ-063AH (8A contact) should
    carry, so the single input becomes two, split rather than paralleled:
    J8 -> F8 -> Q8 -> 12V_A -> bays 1-3
    J9 -> F9 -> Q9 -> 12V_B -> bays 4-5
    Schematic (gen_sch.py / sata_psu.py / verify.py):
    - 12V_MAIN replaced by 12V_A and 12V_B, never joined; ground is common
    - input stage drawn twice from one function; new J9 F9 Q9 C91 C93 D91 R91
    - C82 removed: one 1000uF per input
    - fuses 10A -> 8A, matching the jack contact rating
    - check_rails rule 4: a 5V link group may not straddle the two inputs
    Board (64.9 x 78.8 mm, top edge moved up 2.8 mm, 118 parts):
    - input ba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
    [bom.csv, digikey_bom.csv, digikey_cart_upload.csv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]
